novaclaw38/esp32-fermentation--app/DESIGN.md

---
name: Fermentation Monitor Dashboard
description: A dark instrument panel that reads gravity and temperature at a glance, the way a real gauge cluster does.
colors:
  panel-page: "#14110e"
  panel-surface: "#1c1712"
  panel-raised: "#262019"
  panel-border: "#332a20"
  panel-edge: "#453829"
  panel-text-secondary: "#9c8a6e"
  panel-text-primary: "#d9cbb0"
  brew-glow: "#dd9834"
  brew-accent: "#c97f22"
  brew-accent-hover: "#a8631c"
  approach: "#fb923c"
  approach-deep: "#f2751a"
  breach: "#f87171"
  breach-deep: "#ef4444"
  breach-solid: "#b91c1c"
  gauge-track: "#7a654c"
  gravity: "#4ade80"
typography:
  headline:
    fontFamily: "ui-sans-serif, system-ui, sans-serif"
    fontSize: "1.5rem"
    fontWeight: 600
    lineHeight: "1.3"
    letterSpacing: "0.025em"
  title:
    fontFamily: "ui-sans-serif, system-ui, sans-serif"
    fontSize: "0.875rem"
    fontWeight: 600
    lineHeight: "1.4"
    letterSpacing: "0.05em"
  body:
    fontFamily: "ui-sans-serif, system-ui, sans-serif"
    fontSize: "0.875rem"
    fontWeight: 400
    lineHeight: "1.5"
    letterSpacing: "normal"
  label:
    fontFamily: "ui-sans-serif, system-ui, sans-serif"
    fontSize: "0.625rem"
    fontWeight: 500
    lineHeight: "1.2"
    letterSpacing: "0.1em"
  numeral:
    fontFamily: "ui-monospace, SFMono-Regular, Menlo, Consolas, Liberation Mono, monospace"
    fontSize: "1.125rem"
    fontWeight: 600
    lineHeight: "1.1"
    letterSpacing: "normal"
rounded:
  sm: "6px"
  md: "8px"
  full: "9999px"
spacing:
  xs: "8px"
  sm: "12px"
  md: "16px"
  lg: "24px"
components:
  button-primary:
    backgroundColor: "{colors.brew-accent}"
    textColor: "#ffffff"
    rounded: "{rounded.sm}"
    padding: "6px 12px"
    typography: "{typography.body}"
  button-primary-hover:
    backgroundColor: "{colors.brew-accent-hover}"
  button-secondary:
    backgroundColor: "transparent"
    textColor: "{colors.panel-text-primary}"
    rounded: "{rounded.sm}"
    padding: "6px 12px"
    typography: "{typography.body}"
  button-secondary-hover:
    backgroundColor: "{colors.panel-raised}"
  card:
    backgroundColor: "{colors.panel-surface}"
    textColor: "{colors.panel-text-primary}"
    rounded: "{rounded.md}"
    padding: "16px"
  input:
    backgroundColor: "{colors.panel-page}"
    textColor: "{colors.panel-text-primary}"
    rounded: "{rounded.sm}"
    padding: "4px 8px"
  chip:
    backgroundColor: "{colors.panel-raised}"
    textColor: "{colors.brew-glow}"
    rounded: "{rounded.sm}"
    padding: "2px 6px"
    typography: "{typography.label}"
---

# Design System: Fermentation Monitor Dashboard

## Overview

**Creative North Star: "The Instrument Panel"**

The dashboard reads like a real gauge cluster mounted over the fermenter, not a status page pretending to be one. Every device is a radial instrument with a needle, a tick-marked dial, and a tabular numeral at its center — never a card holding a bare number and a colored badge. The ground is a warm charcoal (never pure black) so the panel has a material temperature, and the one recurring accent — amber phosphor glow — lights up nominal readings the way an analog gauge's face would, then shifts to orange and red as a reading approaches or breaches its threshold. This is a code-led build: there was no comp to defer to, so this system is read directly off the shipped dashboard and its two captured viewports, not off intent.

The system stays deliberately quiet everywhere it isn't the gauge. Cards, buttons, and forms are flat 1px-bordered panels with no shadow vocabulary of their own; the only glow in the interface is the state signal on a needle, a dial center, or an unacknowledged alert dot. Nothing decorative competes with that signal.

**Key Characteristics:**
- Warm dark charcoal panel ground, never cold or pure black
- One state vocabulary — nominal / approaching / breached / offline — expressed as glow color *and* glow intensity, reused identically everywhere a reading appears
- Tabular monospace numerals on every live digit; uppercase tracked labels beneath them on the gauge only — everything else is sentence case
- Flat, unshadowed containers; glow is a state signal, not ambient depth
- Focus-dim: bringing one instrument forward dims its neighbors instead of a badge or modal calling it out

## Colors

A single warm charcoal scale carries the whole interface; amber is the one recurring accent, doubling as both the brand color and the "nominal" gauge glow.

### Primary
- **Brew Amber** (`#dd9834` glow / `#c97f22` solid accent): the nominal-state glow on gauge needles and dial centers, and the solid accent for primary actions (Claim device, Create device) and focus rings. The same hue lit (glow) vs. flat (button fill) rather than two different ambers.

### Secondary — gauge state hues
- **Approach Orange** (`#fb923c` / deep `#f2751a`): a reading nearing its threshold — the "approaching" state, with no equivalent in the alert backend; it exists only so the panel can warn before a value actually leaves range.
- **Breach Red** (`#f87171` / deep `#ef4444`): an open alert or an out-of-range reading. Reserved exclusively for this state — never used decoratively.

### Neutral — the panel scale
- **Panel Ground** (`#14110e`): page background.
- **Panel Surface** (`#1c1712`): tile, card, and form background.
- **Panel Raised** (`#262019`): hover surface and badge/chip background.
- **Panel Border** (`#332a20`): default 1px border, divider. No longer used for the gauge track — see the Gauge component note below.
- **Panel Edge** (`#453829`): lighter edge — border/edge role only, no longer used on the gauge dial either (see below). An audit pass found it in use as real body text (alert timestamps, gauge freshness labels, form hints) at ~1.6:1 contrast, far below WCAG's 3:1 floor for any text size. Corrected to Panel Text Secondary wherever it was carrying text.
- **Panel Text Secondary** (`#9c8a6e`): secondary text, the offline-state glow color, and the gauge's tick marks — tinted warm, never plain gray. Lightened from the original `#8a7a63` (4.65:1 on the page background, but only 4.27:1 on the `panel-900` card surface most of this text actually sits against, failing AA there) to hold ≥5.3:1 against every surface it's used on.
- **Gauge Track** (`#7a654c`, gauge-specific, not a shared panel step): the dial's static ring. Started life at Panel Border's `#332a20` (1.26:1 against `panel-900` — effectively invisible, leaving the needle floating with no scale to read it against), which read as illegible rather than merely subtle. Sits between Panel Edge and Panel Text Secondary on the ramp, clearing WCAG's 3:1 non-text floor (3.21:1 / 3.40:1) while staying visibly dimmer than the tick marks it frames.
- **Panel Text Primary** (`#d9cbb0`): primary text on dark.

### Named Rules
**The Glow-Carries-State Rule.** A gauge's state is never color alone. Nominal, approaching, breached, and offline each pair a hue with a distinct glow radius (3px / 5px / 9px / none) so severity reads as intensity before hue even registers — the alert-brightness raise. Don't reintroduce state as a separate badge or icon once a gauge already carries it.

**The One Amber Rule.** `brew` is the only accent hue in the system outside the state vocabulary. It is not spent on decoration — only on the nominal glow and on primary actions.

## Typography

**Body/UI Font:** system sans stack (`ui-sans-serif, system-ui`) — unchanged from category default, deliberately not a webfont; nothing extra to load for a device meant to work on a weak connection.
**Numeral Font:** `ui-monospace, SFMono-Regular, Menlo, Consolas, Liberation Mono, monospace` — every live readout only.

**Character:** Plain system sans for everything that's prose or label; monospace tabular numerals reserved strictly for live instrument readings, so the two faces stay legible as two different kinds of information (words vs. measurements) rather than a stylistic pairing.

### Hierarchy
- **Headline** (600, 1.5rem/24px, sentence case): page titles ("Your devices", a device name).
- **Title** (600, 1rem/16px, sentence case, `panel-200`): section headers (Alerts, Fermentation, chart titles).
- **Body** (400, 0.875rem/14px): device metadata, form copy, alert reasons.
- **Label** (500, 0.625rem/10px, uppercase, tracked 0.1em): gauge instrument labels (TEMP, GRAVITY, BATTERY) only. The one place all-caps survives — it's the gauge's printed face.
- **Numeral** (600, monospace, 1.125rem sm / 1.875rem lg, `font-variant-numeric: tabular-nums`): the live digit at a gauge's center. Fixed digit width so an update never reflows its label.

### Named Rules
**The Tabular Numerals Rule.** Every live-updating digit — gauge readouts, alert temperatures — uses the monospace stack with tabular-nums. This is a legibility mechanism (digits don't jitter in width as a value ticks over), not a "technical" costume, so it is never applied to static or non-numeric text.

## Layout

A single centered column (`max-w-3xl`, `mx-auto`, `px-4 py-8`) at every breakpoint — this is a monitoring tool for a handful of devices, not a dense dashboard grid. The device list breaks into instrument tiles: one column on mobile, two columns at `sm` and above. Spacing rhythm runs `gap-3`/`gap-4` between tight sibling elements (tile contents, form fields) and `mb-6`/`mb-8` between major sections; card interiors pad at `p-4` (list tiles, settings) or `p-6` (the detail hero panel).

Device settings live on their own route (`/devices/:id/settings`) rather than inline on the detail page, split across four tabs — Profile, Setup, Tools, Data — grouped by what a visit is actually for (identity, configuration, one-off actions, destructive/data controls) rather than by underlying table. Each tab still stacks its cards in the same single column, `space-y-6` apart; nothing about the tab split changes card styling, only which cards are mounted at once.

**Focus-dim.** On the device grid, hovering or focusing one tile dims every other tile to 70% opacity (50% dropped the neighbours' secondary text below AA) over a 300ms transition — the raise borrowed from the streaming-catalog challenger. No badge or modal calls the focused tile out; the neighbors simply recede.

An internal-only admin surface (`/admin/firmware`, gated by an `is_admin()` check rather than anything device-owner-scoped) reuses the same single-column shell, card, form, and button vocabulary as the customer-facing pages — no separate "admin theme." A quiet "Firmware" text link appears in the devices page header only for an admin session; everyone else never sees it.

## Elevation & Depth

The system is flat by default — cards and panels carry a 1px border (`panel-700`) and no box-shadow. Depth and "liveness" are conveyed by glow, not shadow: a gauge's needle and dial center carry an SVG `drop-shadow` sized to the current state (0px offline, 3px nominal, 5px approaching, 9px breached), and an unacknowledged alert gets a small red halo (`0 0 6px 2px`) on its status dot. This is the instrument-panel material reading as lit from within rather than lifted off the page — a deliberate divergence from a generic shadow-elevation system, grounded in the OWN-WORLD's "amber-phosphor glow" mandate rather than a default.

### Named Rules
**The Flat-Except-Lit Rule.** Containers never cast a shadow. The only glow permitted anywhere is the state glow already defined per gauge/indicator — don't add ambient shadow or glow to a card, button, or chip that isn't reporting a live state.

## Shapes

Two radius steps: `6px` (buttons, inputs, chips — the interactive/small scale) and `8px` (cards, tiles, panels — the container scale). Full-round (`9999px`) only on the alert status dot. Borders are 1px and uniform — no accent-colored side borders on any list item or card. The gauge itself is the one non-rectangular silhouette in the system: a 240° dial (120° gap at the bottom, the classic speedometer face) rendered as a single SVG arc per instrument.

## Components

### Buttons
- **Shape:** 6px radius.
- **Primary:** `brew-600` (#a8631c) fill / white text, `hover:bg-brew-500`. Used for the one primary action per view (Claim device, Create device).
- **Secondary/Ghost:** transparent fill, 1px `panel-600` border, `panel-200` text, `hover:bg-panel-800`. Used for Cancel/Add-manually/Sign-out and settings actions.
- Both variants share `min-h-11 px-3 py-2 text-sm font-medium`; no size variant beyond this. Every button, including the confirm-first ones on the settings and admin pages ("Start new batch…", "Unclaim device…", "Remove device…", "Publish"), is at least 44px tall. An earlier note here accepted 38px (`py-2` alone) as a deliberate stop short; the 2026-09-30 polish pass measured those four at 38px and brought them to the same floor as the rest.

### Chips
- **Style:** `panel-800` background, `brew-400` sentence-case text, 12px, `rounded` (not pill). Used exclusively for the device-type badge ("TEMP + GRAVITY") next to a device name/ID — not used as a general-purpose tag.

### Cards / Containers
- **Corner Style:** 8px radius.
- **Background:** `panel-900` surface on `panel-950` page.
- **Shadow Strategy:** none — see Elevation & Depth; flat by default.
- **Border:** 1px `panel-700`, shifting to `brew-600` on hover for the interactive device tile only.
- **Internal Padding:** 16px (list tiles, settings sections) or 24px (detail-page hero panel).

### Inputs / Fields
- **Style:** `panel-950` fill, 1px `panel-600` border, 6px radius, `panel-200` text.
- **Focus:** global 2px `brew-400` outline with 2px offset (themed `:focus-visible`, not a browser default).
- **Error:** inline `breach-400` text beneath the field; no red border treatment observed.

### Navigation
- Minimal: a "← All devices" / "← {device name}" text link (`panel-400`, hover `panel-200`) is the only back-navigation; no persistent nav bar. Section headers use Title type; no active/hover state beyond the link's own color shift.

### Tab Navigation
Used once, on the device settings page: a flat row of sentence-case buttons sharing a single `panel-700` bottom border. The active tab gets `brew-400` text and a 2px `brew-400` underline (the same "solid accent" color as a primary button, not a new hue); inactive tabs are `panel-400`, hovering to `panel-200` — no background fill or pill treatment on either state. This is the same "flat, color-carries-state" logic as the gauge system applied to wayfinding rather than a live reading.

### Gauge (signature component)
The one component every surface composes. A 240°-sweep SVG dial: a dial face (a faint off-center radial dish, `panel-800`→`panel-950`, unique-gradient-ID'd per instance via `useId` so the device grid's several simultaneous gauges don't silently share one gradient definition), a static track (Gauge Track, `#7a654c`), two redline zones marking the device's own approach thresholds, tick marks with a major/minor hierarchy (the two end ticks — min/max — run longer and heavier than the four between them; `#9c8a6e`), an eased needle (700ms cubic-bezier, instant with no easing under `prefers-reduced-motion: reduce`) that pins at its travel limit rather than flying off-scale, and a tabular numeral + uppercase label positioned in the dial's actual clear zone below the arc's lower gap (not a naive full-box overlay — the hub sits at a fixed point regardless of needle angle, and the text has to stay clear of it in every state, not just the ones a screenshot happens to catch). Color and glow are driven entirely by `GaugeState` (nominal/approaching/breached/offline — see `lib/gaugeState.ts`); an offline gauge renders its numeral as "—" at 40% opacity instead of a stale value. Two sizes only: `sm` (112px, list tiles) and `lg` (224px, detail-page hero) — the freshness sub-label ("3m ago") only renders at `lg`, since the clear zone at `sm` holds the numeral and its label legibly but not a third line; staleness still reads through the gauge's own opacity at either size. A device that's overdue but not yet offline dims to 75% opacity rather than adopting a new hue — staleness is intensity, not a new signal. The `aria-label` states severity in words ("above maximum," "approaching threshold") alongside the number, not just the raw value, so the state the glow communicates to a sighted viewer also reaches a screen reader.

**Needle and hub.** A `/impeccable critique` pass (2026-09-18, dual-agent, 20/24) named the exact reason the dial read as amateur rather than premium: the needle was a uniform-width line and the hub a flat filled dot, so nothing on the dial had rendering finish. The needle is now a tapered polygon (wider at the pivot, narrower at the tip) with a thin off-center white-at-30%-opacity highlight line suggesting a machined ridge. The hub is layered — a base disc in the state color, a dark inset ring (`#000` at 40% opacity) standing in for a bezel edge, and a small off-center white highlight dot standing in for a glossy dome — all from the existing state color, no per-state gradient defs needed. Neither adds a new hue; both are built from tokens already in the system (state color + black/white at reduced opacity).

The dial's generic shape and TEMP/GRAVITY/BATTERY labels alone could belong to any monitored-device product — an audit found this explicitly. `endLabels`, an optional `["min", "max"]` pair printed at the dial's two feet, is one counter to that: it's used only on the Gravity gauge, printing real specific-gravity notation ("0.990"–"1.120") the way a hydrometer graduates its scale, and never on Temp/Battery/Tilt. It renders on the `lg` dial only: at `sm` (112px) the labels were clipped by the box edge or collided with the track's end caps, so the small gravity dial relies on its minor graduation instead. The Gravity gauge also gets five faint minor graduation ticks between its six majors (`endLabels`-gated, so this is Gravity-only) — a real hydrometer prints a graduated scale, not six even dashes, and this is the one place the dial's actual silhouette, not just its label content, differs by instrument: Temp and Battery read identically to each other on purpose, Gravity doesn't read identically to either of them.

### Fermentation Summary
Four stat cards (`grid-cols-2 sm:grid-cols-4`), same card shell as everywhere else (`panel-900`/`panel-700`/8px). Original Gravity, Current SG, and Attenuation sit in `panel-200`; ABV alone gets `brew-400` as the headline figure of the group — the one accent among four cards, not four accents. All four values are tabular numerals.

### Fermentation Stage Bar
A read-only status version of Tab Navigation's step logic, not a new pattern: five dots (Lag/Active/Slowing/Cleanup/Complete) joined by connecting rules. The active stage gets a `brew-400` dot with the gauge system's own glow treatment (`drop-shadow`, not a box-shadow); stages already passed hold `panel-400`; stages not yet reached hold `panel-700`. A guidance line underneath states what the stage means and, only when it's genuinely worth a caution (cold ambient or a stalled lag phase), renders in `approach-400` instead of `panel-400` — the same vocabulary a gauge uses for "worth a look," not a new alert channel.

### Fermentation charts
Two additions beside the existing Temperature and Gravity charts: a dual-axis Gravity+Temperature chart (SG on the left axis in the same green already established by GravityChart, temperature on the right axis in `brew-400` dashed, matching TemperatureChart's own line color), and a fermentation-rate area chart (SG points per 24h, same green, filled at 15% opacity) below it. Deliberately two charts and two axes rather than one three-axis chart: a third independently-scaled line on the combo chart was tried and read as noise, not signal, the same legibility call GravityChart itself made when it chose not to plot raw tilt and corrected SG together.

### Instrument Mark
A 40px wordmark glyph — the same 240°-dial/needle/glow grammar as Gauge, at a fixed "nominal" angle rather than a real reading (it's a mark, not an instrument; it never claims to measure anything). The one authored moment on the sign-in threshold: on mount the needle sweeps from zero to its resting angle and the glow fades in over ~900ms, once, never looping. Skips straight to the resting frame under `prefers-reduced-motion: reduce`. This is deliberately the first thing a visitor who hasn't claimed a device yet sees — the sign-in page previously carried none of this system (default Tailwind `stone` grays on an unset background, no dark panel ground), which read as an unfinished, unbranded form bolted in front of a finished product. Rebuilt onto the same card/input/button tokens as everything else in Components below.

### Loading & empty states
A gray spinner or bare "Loading…" text breaks the instrument-panel illusion at the one moment — first paint — it matters most. The device grid's loading state is a grid of dial-shaped skeleton tiles (`GaugeTileSkeleton`: the dial's silhouette in Gauge Track `#7a654c`, gently pulsing, no spinner) previewing the exact layout about to render, not a generic placeholder. An audit caught this stroke at `panel-700` (`#332a20`, 1.26:1 against the card surface) in an earlier pass — the same near-invisible-track bug the real Gauge had already been fixed for once, reintroduced in the copy that was supposed to preview it; screenshotting the two side by side is what caught it, contrast math alone wouldn't have. `animate-pulse` is disabled under `prefers-reduced-motion: reduce` globally (see `index.css`). The zero-devices empty state composes the real `Gauge` component in its own `offline` pose — dim numeral, no glow — as the centerpiece, with copy that treats it as "your first instrument, not yet wired in" rather than an apology; this reuses the system's own signature silhouette instead of a generic icon-plus-heading card.

## Do's and Don'ts

### Do:
- **Do** use the four-state vocabulary (nominal/approaching/breached/offline) — and its paired glow intensity — for any future live-reading indicator, not just Gauge.
- **Do** keep every live-updating digit in the monospace tabular stack.
- **Do** keep containers flat (1px border, no shadow); reserve glow strictly for state signaling.
- **Do** theme browser-default surfaces (selection, scrollbar, focus ring) from the panel/amber palette rather than leaving them at browser defaults.

### Don't:
- **Don't** add a status badge or icon next to a gauge — the instrument already carries its own state.
- **Don't** introduce a second accent hue; amber is the only accent outside the state vocabulary.
- **Don't** add shadows, colored side-borders, or gradients to cards, chips, or buttons — those are not part of this system.
- **Don't** widen the gauge beyond its two sizes (sm/lg) or break its 240° dial into a full circle; the speedometer face is the signature silhouette.

## Palette additions (2026-09-23 audit)

All colors now come from one module, `dashboard/src/lib/tokens.ts`, which
`tailwind.config.ts` builds its theme from and which SVG and Recharts code
imports directly. Three values that existed only as literals were promoted
into it:

- **`gravity` `#4ade80`**: the gravity data series (GravityChart, the combined
  chart, the rate chart). The one data hue that isn't a gauge state: it has to
  read as a different quantity beside the amber temperature line, not as a
  warning. 10.2:1 on panel-900.
- **`gauge-track` (`panel-500`) `#7a654c`**: the dial track and skeleton arc,
  chosen to clear the 3:1 non-text contrast floor against both panel surfaces.
- **`breach-solid` (`breach-700`) `#b91c1c`**: fill for solid destructive
  buttons. White on `breach-500` held only 3.76:1; this holds 6.5:1.

Primary buttons now darken on hover (`brew-600` → `brew-700`) instead of
lightening to `brew-500`, where white text fell to 3.21:1.

An offline gauge no longer draws its needle: resting at the bottom of its
travel, it read as "reading at the minimum".

## Sign-in and password reset (2026-09-23 critique)

Both pages share `components/auth/AuthShell` (page frame) and
`components/auth/AuthField` (labelled field), so they can't drift apart.

- **Frame:** anchored near the top (`pt-[12vh]`/`16vh`), not vertically
  centred. Centring re-centred the card, and moved the header 40–90px, every
  time an error or notice appeared. The Instrument Mark is 48px beside a
  one-line product name. Each mode has its own `h1` ("Sign in", "Create your
  account", "Reset your password", "Check your inbox") and its own
  `document.title`.
- **Fields:** labels are sentence case (`text-sm font-medium panel-400`;
  all-caps is the gauge's alone) and are tied to their inputs
  with `htmlFor`/`id`. Nothing else ever sits inside a `<label>`. Inputs are
  44px tall with a `panel-500` border (3.21:1 against the card, clearing the
  3:1 floor for UI boundaries) that turns `breach-400` in error. Placeholders
  use `panel-400`, not the browser's gray. Hints are persistent text below the
  field, never only a placeholder. Passwords have a show/hide control.
- **Validation:** the forms use `noValidate`, so the browser's white native
  tooltip never appears on the dark panel. Errors are per-field
  (`aria-invalid`, `aria-describedby`), and focus moves to the first invalid
  field. Sign-in never enforces the password length.
- **Errors in the product's words:** `lib/authErrors.ts` maps Supabase's
  strings to plain-language copy and a recovery action: reset the password
  (keeping the email), resend confirmation, or sign in instead. The error box
  takes focus.
- **Busy state:** a solid `brew-800` fill with `panel-200` text (5.70:1) and
  `aria-busy` on the form. Opacity-50 had dropped the label to 3.49:1.
- **Sent states:** "Check your inbox" replaces the form entirely, with the
  address (wrapping), a resend action and "Use a different email". No live
  submit button is left under a "we sent it" message.
- **Mark motion:** the glow now fades up (a `filter` transition from a 0px to
  a 3px drop-shadow) as the needle arrives, instead of switching on.
- **Browser surfaces:** `color-scheme: dark` on `:root`, and autofill is
  restyled to the panel ground with a brew caret.

## Atelier audit (2026-09-24)

A full audit (`/atelier audit`, rendered at 375 and 1440px with fixture
data) found the dashboard grounded but mis-weighted and the landing page on
a different, generic system. Changes:

- **Gravity is the hero on a calibrated float.** PRODUCT.md's second
  principle is "one device replaces two", but gravity was a 112px dial the
  size of battery. The `lg` dial now reads gravity (with the freshness line);
  temperature moves to `sm` and keeps its state glow, which is where alerts
  show. Hubs and uncalibrated floats keep temperature on the `lg` dial.
  Gravity end labels now sit inside the ring above each foot: outside the
  arc they hit the end caps; below the feet they lined up with the numeral.
- **Device tiles** show a float's gravity as the tile's largest number
  (hidden while the device is offline, so a days-old value can't read as
  current). The gauge stays on temperature.
- **Open alerts are named on the tile** in `breach-400` ("Sensor not
  reading, last seen 3d ago"). An offline gauge carries no glow, so a dead
  sensor used to look identical to a switched-off device — the one failure
  the product exists to prevent.
- **One chart, not three.** A calibrated float shows a single gravity +
  temperature chart with the temperature limits drawn on it, then the rate
  chart. The separate temperature, gravity and combined charts repeated the
  same two lines. Hubs keep the temperature chart; uncalibrated floats keep
  the tilt chart. The temperature-correction note is hidden below half a
  gravity point. Rate-chart ticks are whole gravity points.
- **One time format.** `formatDateTime` in `lib/chartTime.ts` ("Sep 23,
  08:51") everywhere an absolute time appears; `formatDate` for date-only.
  Alerts previously printed `9/23/2026, 8:51:16 AM`.
- **Sentence case.** All-caps is reserved for gauge labels and claim codes.
  Page titles, section heads, stat labels, stage names, tabs, chips, auth
  field labels and the sign-in wordmark are sentence case; section heads
  moved from `panel-400` 14px caps to `panel-200` 16px so they still lead.
- **44px inputs** everywhere, not just the auth forms.
- **Landing page** (`landing/`) now uses this palette and type, so a visitor
  and a signed-in owner are in the same world. Its hero is an example
  gravity curve on a hydrometer-style scale (labelled as an illustration),
  drawn once on load with the gravity glow; copy is unchanged.

## Atelier audit, second pass (2026-09-29)

A re-audit of the dashboard after the first round found nothing broken and
four craft gaps, all fixed:

- **Chart ticks sit on clean local-time boundaries.** `timeTicks` in
  `lib/chartTime.ts` places them every 1–48 hours (6 on a 48-hour chart:
  midnight, 6 AM, noon, 6 PM), labelled "Mon 6 PM" by `formatTickTime`. The
  tooltip keeps the full date and time. Recharts' own ticks were spaced from
  the first reading and landed on times like 07:14 AM.
- **Tiles say how old an open alert is**, and when a temperature alert's
  reading has returned inside the limits: "Above maximum 40m ago; back in
  range now". The alert stays open, and the gauge stays lit, until it's
  acknowledged. `describeOpenAlert` in `lib/alerts.ts` builds the text; the
  age uses a non-breaking space so a wrapped line never splits "40m / ago".
  Status lines use `text-balance`.
- **Time in range fills the hero panel** (`components/TimeInRange.tsx`,
  maths in `lib/timeInRange.ts`): "Last 48 hours, 22.0°C to 28.0°C", the hours
  spent inside those limits, and when the ferment last left them. Each
  reading holds for up to four wake intervals, the same ceiling
  `lib/connection.ts` uses before calling a device offline. Time beyond that
  is reported as "No readings for N hours", never counted as in range. Hidden
  until history has loaded and until there's an hour of data.

## Delight: the wake (2026-09-29)

One authored moment on the gauge, drawn from the product's first principle
("Never go silent"): when a gauge that is already on screen goes from offline
to live -- a device reporting for the first time, or coming back after going
silent -- the instrument wakes. The needle sweeps in from zero on the
sign-in mark's curve (900ms, `cubic-bezier(0.16, 1, 0.3, 1)`), the glow and
hub warm up behind it, and the numeral lands as the needle arrives.

- **Only on an observed transition.** It never plays on first paint, so a page
  of gauges doesn't sweep on every visit. It's skipped under
  `prefers-reduced-motion`.
- **State changes settle instead of snapping.** Needle and hub colour and glow
  now transition (400ms), so acknowledging an alert or a reading crossing its
  limit reads as the instrument responding. The acknowledged alert's dot
  fades to grey over 500ms.
- **Waiting is named.** A claimed device that has never reported says
  "Waiting for its first reading" on its tile and "Waiting for first reading"
  under its dial, not just "Hasn't reported yet" beside a dead dial.
- Implemented in `Gauge.tsx` as a small `idle → start → sweep` state driven by
  a layout effect, so the needle is never painted at its final angle before
  the sweep begins. No new dependency.

## Polish pass (2026-09-30)

An end-to-end pass over the paths around the happy path (login modes, empty,
loading and error lists, the claim and add forms, uncalibrated, never-reported
and offline devices, all four settings tabs, the admin page), rendered at 375
and 1440px and checked with axe-core (WCAG A/AA and best practices). It found
one misleading state and a handful of finish gaps:

- **A silent device no longer looks new.** A device that has reported before but
  has nothing in the 48-hour window used to show "No gravity readings yet." and
  "Not enough history yet to chart a rate." beside dead dials. The detail page
  now says "No readings in the last 48 hours. This device last reported 3d ago.
  Check that it has power and can reach your WiFi." in place of the charts.
- **Chart value axes are evenly spaced.** `niceTicks` in `lib/axisTicks.ts`
  picks a 1/2/5 step (whole degrees for temperature, at least half a gravity
  point for gravity), and each chart uses the first and last tick as its
  domain. Recharts' own ticks had put one at each end of a padded domain and
  rounded the rest: 1.065 / 1.040 / 1.025 / 1.010, or 17 / 20 / 23 / 27.
- **Admin firmware file inputs have labels** (axe: critical).
- **The four short buttons reach 44px**, the file inputs and the device-type
  radio rows too.
- **Low-battery field** stacks its label above the input like every other
  settings field; the calibration placeholders are example values (`0`), not a
  truncated copy of the hint beneath.

Left as they are: inline links inside sentences (exempt from the target-size
minimum), and native radio and checkbox controls whose labels are the full-size
target.
