novaclaw38/esp32-fermentation--app/docs/AUDIT-2026-09-23.md

# Full audit: code and UI (2026-09-23)

Scope: `dashboard/` (React/Vite), `supabase/` (migrations, RLS, `alert-notify`),
`firmware/` (both sketches), and `landing/`. This report lists findings and
suggested changes only. Nothing was fixed in this pass.

## How the evidence was gathered

- Read every source file in `dashboard/src`, every migration, the edge function,
  the landing page, and the risky parts of both firmware sketches (config
  fetch, OTA, sleep, portal, fault paths).
- `tsc --noEmit`: passes. `vite build`: passes (main chunk 457 KB / 130 KB gz;
  lazy Recharts chunk 373 KB).
- `npm run lint`: **fails**. ESLint 9 is installed, but the repo only has
  `.eslintrc.cjs`, which ESLint 9 no longer reads.
- `impeccable detect`: `dashboard/src` is clean. `landing/` has only
  advisory palette and radius drift, because it uses a separate light visual
  world.
- Rendered the real app in headless Chromium with mocked Supabase responses
  (three devices: one tilt device with 48h of data, one hub with an open
  alert, and one offline hub) at 1280px and 375px.
- WCAG contrast was computed for every foreground/background pair flagged below.
- Not tested: real devices, Realtime, touch gestures, and the email path.

---

## Audit health score

| # | Dimension | Score | Key finding |
|---|---|---|---|
| 1 | Accessibility | 2 | Unlabeled landing inputs; stage-bar labels at 1.26:1; the danger button fails AA; no tab semantics and no live regions |
| 2 | Performance | 3 | Charts are already lazy-loaded; admin and settings ship in the main chunk; the device list pulls 500 rows to find the latest reading per device |
| 3 | Responsive design | 2 | **Verified:** `/devices` overflows a 375px phone by 96px, and "Sign out" is clipped offscreen |
| 4 | Theming | 2 | Tokens exist in Tailwind, but about 40 hex literals are duplicated in Gauge and the charts; the gravity green `#4ade80` is outside the palette |
| 5 | Implementation integrity | 2 | The "Complete" stage can never be reached; a page left open never goes stale or offline; the rate chart is mislabeled |
| **Total** | | **11/20** | **Acceptable: significant work needed** |

### Implementation integrity verdict: pass, with defects

The visual system is coherent and specific to this product. It uses one
instrument vocabulary (the four gauge states), a warm panel palette, SG
notation on the gravity dial, and honest empty and error states that never
pose as reassurance. The main defects are in behavior rather than style. Two
of them break the product's own first principle, "Never go silent": the live
page cannot notice that a device has died, and the analytics state machine
cannot reach its final state.

---

## Executive summary

- **Findings:** 4 P0, 11 P1, 14 P2, 5 P3.
- **Top issues:**
  1. **P0:** A dashboard left open never shows a device going offline.
  2. **P0:** The `alert-notify` edge function accepts unauthenticated requests when `WEBHOOK_SECRET` is unset.
  3. **P0:** An empty "Sleep interval" field saves `0` to the device, and the firmware applies it without bounds.
  4. **P0:** "Complete" can never be reached, and the analytics mix in readings from the previous batch.
  5. **P1:** The device-list header breaks on phones, and several WCAG AA contrast and labeling failures remain.
- **Recommended next steps:** fix the four P0s (all small, local changes). Then
  add the missing `CHECK` constraints and restore lint, then run a UI pass
  for mobile, accessibility and token cleanup.

---

## P0: blocking

### [P0] Connection status is frozen at page load
- **Location:** `dashboard/src/pages/DeviceDetail.tsx:187`, `dashboard/src/pages/Devices.tsx:271`, `dashboard/src/lib/connection.ts`
- **Category:** Implementation integrity
- **Impact:** `getConnectionInfo(device, new Date())` only runs on render. No
  timer or `visibilitychange` handler triggers a re-render, and the Realtime
  handler appends readings without updating `device.last_seen_at`. If a
  device dies while the page is open, it keeps showing "online, 5m ago"
  indefinitely, and the "5m ago" label never advances. This contradicts
  Product Principle 1.
- **Fix:** Add a `useNow(30_000)` hook that ticks every 30s and on tab focus,
  and use it everywhere connection status is computed. In the Realtime
  reading handler, also update `last_seen_at` (`setDevice(d => ({...d, last_seen_at: row.created_at}))`).
  On `/devices`, either subscribe to `readings` inserts or re-fetch on an
  interval and on focus.

### [P0] The edge function accepts unauthenticated requests
- **Location:** `supabase/functions/alert-notify/index.ts:108`
- **Category:** Security
- **Impact:** The check is `if (WEBHOOK_SECRET) { ...check... }`, and
  `verify_jwt = false`. If the secret is unset, which is easy to miss because
  the setup has three manual steps, anyone can POST a forged `record`. The
  function then emails the real owner of any device ID, using the real device
  name, which makes it a phishing relay. It also trusts the payload body
  instead of the database.
- **Fix:** Return 500 when the secret is missing and use a constant-time
  comparison. Re-read the alert by `record.id` with the service role and use
  that row, not the posted one.

### [P0] An empty numeric field saves 0, and the firmware applies it unchecked
- **Location:** `dashboard/src/components/ThresholdForm.tsx:25-30`; `supabase/migrations/*` (no `CHECK` constraints); `firmware/*/…ino` `fetchRemoteConfig()` (tilt sketch around line 459)
- **Category:** Implementation integrity / hardware safety
- **Impact:** `Number("")` is `0`. Clearing "Sleep interval" and saving
  writes `sleep_interval_seconds = 0`. The device reads it with no bounds
  check and calls `esp_sleep_enable_timer_wakeup(0)`, so it wakes
  continuously, keeps WiFi up and drains the cell. The dashboard then computes
  every status as `offline`, because the grace period is `0 * 1.5`. The same
  applies to min/max temperature (silently set to `0`) and to the breach limit.
- **Fix:** Apply all three layers:
  1. Form: reject empty or non-finite values.
  2. Database: add `CHECK (sleep_interval_seconds between 60 and 86400)`,
     `CHECK (consecutive_breach_limit between 1 and 100)`, and
     `CHECK (temp_min_c < temp_max_c)`.
  3. Firmware: clamp remote values before using them.

### [P0] Fermentation analytics: "Complete" is unreachable and the analytics mix batches
- **Location:** `dashboard/src/lib/fermentationAnalytics.ts:134-141`, `:167-170`; `DeviceDetail.tsx:113`
- **Category:** Correctness
- **Impact:** Readings are fetched with `created_at >= now - 48h`.
  `hasFullPlateauWindow` requires `points[0].t <= latest.t - 48h`, which
  cannot be true for that window. As a result, the stage never gets past
  "Cleanup", and the guidance never says "ready for bottling". Separately,
  the rate and stage calculations use every reading in the window, including
  readings from before `fermentation_started_at`. After a "Start new batch"
  reset, the old batch's plateau pollutes the new batch's stage.
- **Fix:** Fetch history from `min(now - 48h, fermentation_started_at)`, or
  fetch a slightly wider window (for example 72h) for the analytics.
  Filter points to `t >= fermentation_started_at` before computing the rate
  and stage. Add unit tests; the module is pure and easy to test.

---

## P1: major

| # | Issue | Location | Suggested fix |
|---|---|---|---|
| 1 | **Device-list header overflows on phones.** Verified: `scrollWidth` is 471px at 375px, "Sign out" is clipped, the unit toggle wraps onto three lines, and the "TEMP + GRAVITY" badge truncates to "TEMP + …" | `Devices.tsx:119-147` | Put the title on its own row and wrap or scroll the action row. Move Firmware and Sign out into an overflow menu or footer. Let the badge wrap. `/impeccable adapt` |
| 2 | **Stage-bar future labels are 1.26:1** (`text-panel-700` on `panel-900`). They were visually unreadable in the screenshot. Nothing tells a screen reader which stage is current. | `FermentationStageBar.tsx:81` | Use `text-panel-400` at reduced weight for future stages. Wrap the bar in `<ol>` and add `aria-current="step"`. |
| 3 | **Danger buttons fail AA.** White on `breach-500` is 3.76:1, and the hover state is 2.77:1. | `RemoveDeviceForm.tsx:71`, `BatchForm.tsx:71` | Use `panel-950` text on `breach-400`, or darken the fill to about `#b91c1c`. |
| 4 | **Landing inputs have no labels**, only placeholders, which fails WCAG 1.3.1 and 3.3.2. The success and error messages are not announced to screen readers. | `landing/index.html:24,74-75` | Add a `<label>` (visually hidden is fine) and put `aria-live="polite"` on `.signup-message`. |
| 5 | **Landing copy promises features that don't exist:** "emails you when … a stalled fermentation" (the firmware says stall detection "belongs in a backend job", and none exists), "Readings every few minutes" (the default is 15 min), and "clip it on" (describes only the Hub). PRODUCT.md forbids unverified claims. | `landing/index.html:21-47` | Rewrite the copy to match shipped capability, or build the stall alert first. `/impeccable clarify` |
| 6 | **The login page shows operator instructions to end users** ("Turn off … Confirm email in the Supabase dashboard"). It also nudges the operator toward disabling email confirmation; `config.toml` already has `enable_confirmations = false`. Unverified signups make the per-account claim rate limit easy to multiply. | `Login.tsx:65-71`, `supabase/config.toml` | Show "Check your email to confirm your account", and keep confirmations on in production. Add a password-reset flow, which is currently missing entirely. |
| 7 | **Unclaim/transfer gives the next owner the previous owner's full history** (readings and alerts stay attached to the `device_id`). That is a privacy leak when a unit is sold or given away. | `20260917090000_settings_expansion.sql` `unclaim_device()`; UI copy in `UnclaimDeviceForm.tsx:40` | Store `claimed_at` as an ownership epoch, and have RLS or the views only expose rows with `created_at >= claimed_at`. Or offer "transfer with history" and "wipe history" as separate actions. |
| 8 | **Unsigned OTA over `setInsecure()` from a public bucket.** When `OTA_ENABLED` is turned on, anyone who can intercept the device's network traffic can push firmware to it. | both sketches `checkForOTAUpdate()` | Pin the Supabase CA (`setCACert`) and add a signature or SHA-256 to the manifest that the device verifies. Block enabling OTA until both are done. |
| 9 | **Owners can write every device column**, including `device_secret`, `claim_code`, `last_seen_at`, `og_*` and `device_type`, and `select("*")` returns `device_secret` to the browser. | `init_schema.sql` "users update own devices"; `useDevice.ts:24` | Use column-level `GRANT UPDATE (name, temp_min_c, …)` for `authenticated`. Revoke `SELECT` on `device_secret` and `claim_code`, and select explicit columns. |
| 10 | **The device list ignores failed side queries.** If the readings or open-alerts fetch fails, the list shows "—" or a nominal gauge instead of an error, which is the silent failure the app's own comments warn against. | `Devices.tsx:72-86` | Check `error` on both queries and show a partial-load notice. |
| 11 | **Lint is broken** (ESLint 9 with the legacy config), and there is no CI and no tests. `react-hooks` rules that would have caught the frozen-clock bug aren't running. | `dashboard/.eslintrc.cjs`, repo root | Migrate to `eslint.config.js`. Add a GitHub Action running `tsc`, `lint`, `build` and Vitest, and start with tests for `fermentationAnalytics`, `gravity`, `connection` and `gaugeState`. |

---

## P2: minor

| Issue | Location | Suggested fix |
|---|---|---|
| **The rate chart is mislabeled.** The heading says "SG per 24h", but the values are points (`+112.0`), and the tooltip says "+112.0 SG/24h" | `FermentationRateChart.tsx:42,46`; `DeviceDetail.tsx:340` | Label it "points / 24h" |
| **The charts use a category X axis**, so a 10-hour gap draws as one continuous segment and time is distorted | all four charts | Use `XAxis type="number" scale="time" dataKey="t"` with a tick formatter |
| **The gravity dial's end labels are clipped and illegible at the small size** (`0.99` is cut off on mobile) | `Gauge.tsx:149-150` | Drop the end labels below the large size, or move them inside the arc |
| **Hard-coded °C text ignores the unit toggle** in the lag guidance, the gravity correction note and the alert email | `FermentationStageBar.tsx:33`, `GravityChart.tsx:137`, `alert-notify` | Route it through `formatTemp` |
| **Stale copy:** "Enter the coefficients under *Gravity calibration* below", but calibration now lives on the Settings page | `GravityChart.tsx:97` | Link to `/devices/:id/settings` (Setup tab) |
| **The email subject says "out of range" for battery and sensor alerts** and the body has no dashboard link; the timestamp is raw UTC ISO | `alert-notify/index.ts:69-70` | Write a subject per reason, add a dashboard URL, and format the time |
| **Snooze copy says only "temperature and battery"** alerts are held back, but `ingest_alert` also drops `sensor_fault` | `SnoozeForm.tsx:46`; `settings_expansion.sql` | Either let `sensor_fault` through while snoozed (recommended, per Principle 1) or fix the copy |
| **The claim success message never shows**, because `onClaimed` hides the form immediately | `ClaimDeviceForm.tsx:74-76`, `Devices.tsx:151` | Keep the form open briefly or show a banner at page level |
| **A failed acknowledge is silent**, and there's no busy state, so a double-tap is possible | `AlertList.tsx:22-25` | Surface the error and disable the button while in flight |
| **The skeleton dial is 56px, but the real small gauge is 112px**, so the layout shifts when data loads | `GaugeTileSkeleton.tsx:29` | Match the 112px size |
| **Latest reading per device comes from `limit(500)` across all devices**, so a quiet device can show "—" even though it has readings | `Devices.tsx:72-76` | Use a `latest_readings` view with `DISTINCT ON (device_id)` |
| **Settings tabs lack `role="tablist"`, `aria-selected` and arrow-key support**, the tab isn't in the URL (it resets on reload), and there are `h3`s with no `h2` | `DeviceSettings.tsx:80-94` | Use `?tab=`, add ARIA tab semantics, and fix the heading levels |
| **Several touch targets are under 44px**: the unit toggle, Acknowledge, and the snooze chips (`px-2 py-1 text-xs`) | `UnitToggle.tsx`, `AlertList.tsx`, `SnoozeForm.tsx` | Set `min-h-[44px]` on touch devices |
| **About 40 hex literals duplicate Tailwind tokens**, and the gravity green `#4ade80` is outside the DESIGN.md palette | `Gauge.tsx`, all charts | Export a `tokens.ts` from `tailwind.config.js` as the single source, and add `gravity` to the palette and DESIGN.md |
| **The database accepts garbage readings**: there is no range check on `temperature_c` or `tilt_deg`, and `alerts.reason` is free text | migrations | Add `CHECK` constraints (for example, temperature between -40 and 125, tilt between 0 and 90, and `reason` in a known set) |
| **The waitlist has no rate limit or email-format check** (anonymous insert) | `init_schema.sql` | Add a `CHECK` on the email format, and route inserts through an RPC with a per-IP or captcha gate |
| **The alert webhook URL is the placeholder `YOUR_PROJECT`** in a tracked migration, so applying it as-is silently sends no email | `20260910124500_alert_insert_webhook_trigger.sql` | Read the URL from Vault like the secret, and fail loudly if it's missing |

## P3: polish

- Device secrets are stored in plaintext. Store `sha256(secret)` and compare hashes in `verify_device_secret`.
- Admin and Settings routes ship in the main chunk. Wrap them in `lazy()` like the charts, which would cut about 60 KB from first paint for the login screen.
- The offline gauge still draws a needle pinned at the minimum, which reads as "reading at minimum". Hide the needle or park it in the bottom gap when offline.
- The label is `"TEMP"` in `Devices.tsx:296` and `"Temp"` in `DeviceDetail.tsx:240`; it renders uppercase either way, so standardize the source string.
- Focus-dim sets neighboring tiles to `opacity-50`, which drops their secondary text below AA while hovering. Use about `opacity-70` instead.
- There's no retention policy on `readings`. At 96 rows per device per day, plan for partitioning or rollups.

---

## Patterns and systemic issues

1. **Validation lives only in the UI.** The database has almost no `CHECK`
   constraints and the firmware trusts remote config, so any UI bug (the
   `Number("")` bug here) reaches the hardware. Put the source of truth in
   Postgres.
2. **Time is computed once per render.** Any value derived from `Date.now()`
   (connection status, "ago" labels, mute expiry, lag hours) goes stale.
   One shared clock hook fixes all of them.
3. **Colors are duplicated across three sources**: Tailwind config, inline hex
   in SVG and Recharts props, and the landing page's own CSS variables.
4. **There is no automated safety net.** Lint doesn't run, and there are no
   tests or CI. The analytics bug would have been caught by one unit test.

## What's working

- The empty, error and loading states are honest. `loadError`, `notFound` and
  "Couldn't load history" are all distinct from real emptiness, which is rare
  and valuable.
- The gauge is solid instrument work: four states distinguished by both hue
  and glow size, `aria-label` values that include direction ("above
  maximum"), reduced-motion snapping, tabular numerals, and `useId` gradient
  scoping.
- The security model is mostly sound: device RPCs with per-device secrets, a
  `security_invoker` view, RLS-scoped multi-tenancy, a rate limit designed
  around the transaction-rollback problem, an unbiased claim-code alphabet,
  and careful `REVOKE … FROM PUBLIC` hygiene.
- Recharts is lazy-loaded with fallbacks sized to each chart, so there's no
  layout shift when a chart arrives.
- The firmware reports sensor faults instead of going silent, times out the
  I2C bus, escapes SSIDs in the captive portal, and times out the portal to
  save the battery.
- The code comments explain *why*, which made this audit fast.

---

## Recommended actions, in order

1. **[P0] `/impeccable harden`**: the clock hook plus Realtime `last_seen_at`
   updates, the fail-closed webhook, numeric validation in all three layers,
   and the analytics window and batch filter.
2. **[P1] Backend hardening** (not a design command): `CHECK` constraints,
   column grants, a history boundary on transfer, and OTA signing.
3. **[P1] `/impeccable adapt`**: the device-list header on mobile, touch
   targets, and the gravity dial's end labels.
4. **[P1] `/impeccable audit` fixes for accessibility**: stage-bar contrast
   and ARIA, danger-button contrast, landing labels and live regions,
   settings tab semantics.
5. **[P1] `/impeccable clarify`**: landing claims, login copy, the email
   subject and body, snooze copy, the stale calibration pointer, and the
   rate-chart units.
6. **[P1] Tooling**: an ESLint 9 flat config, Vitest for `lib/`, and a
   GitHub Actions CI workflow.
7. **[P2] `/impeccable extract`**: a `tokens.ts` single source, with gravity
   green added to the palette and DESIGN.md.
8. **[P2] `/impeccable layout`**: time-scaled chart axes and a skeleton that
   matches the real tile size.
9. **`/impeccable polish`**: a final pass.

You can ask me to run these one at a time, all at once, or in any order.
Re-run `/impeccable audit` after the fixes to see the score change.

---

## Resolution (same day)

Every finding above was addressed. Only the database migration still has to
be *applied* to the hosted project (see "Deploy steps" below).

**How the fixes were verified:**
- **Dashboard:** `npm run typecheck`, `npm run lint` (0 warnings) and `npm test` pass. There are 20 Vitest tests; the "Complete is unreachable" test was confirmed to fail against the old 48h window. `npm run build` passes, and the main chunk dropped from 457 KB to 419 KB.
- **Migrations:** all 14 applied cleanly to Postgres 16, both fresh and as an upgrade over existing data. The upgrade was exercised against the new behavior:
  - device secrets are hashed, and devices still authenticate with plaintext
  - `select *` on `devices` and writes to `device_secret` / `last_seen_at` are denied
  - a 0 sleep interval and min ≥ max are rejected
  - a new owner sees none of the previous owner's history
  - `sensor_fault` gets through a snooze
  - an unconfigured webhook logs a warning without blocking the alert insert
  - waitlist signups are validated and rate-limited
  - a −127 °C reading is rejected
- **Edge function:** `deno check` passes.
- **Firmware:** both sketches compile with `arduino-cli` for `esp32:esp32:esp32` (core 3.3), using 80% and 85% of program space.
- **UI:** re-rendered in headless Chromium at 375px and 1280px. `/devices` no longer overflows (it was 96px too wide), and the design detector is clean.
- **CI:** `.github/workflows/ci.yml` now runs all of the above on every PR.

| Finding | Fix |
|---|---|
| P0 frozen connection status | `useNow()` ticks every 30s and on tab focus; Realtime updates `last_seen_at`; the device list refreshes every 60s and on focus |
| P0 edge function accepts unauthenticated requests | Fails closed without `WEBHOOK_SECRET`, compares the secret in constant time, and re-reads the alert by id |
| P0 empty field saves 0 | Form parses fields explicitly, the database has `CHECK` constraints, and the firmware clamps remote config |
| P0 analytics | 72h analytics history (48h charts), readings filtered to the current batch, regression tests added |
| P1 mobile header | Utility row, then the title, then wrapping actions |
| P1 stage-bar contrast | Upcoming stages at 5.3:1, `<ol>` with `aria-current="step"` |
| P1 danger buttons | `breach-700` fill (6.5:1); primary hover darkens (7.1:1) |
| P1 landing accessibility | Labels, `role="status"` / `aria-live` on messages, `<ol>` steps, focus ring |
| P1 landing claims | Copy rewritten to match what ships (15-min readings, the actual alert types, both form factors) |
| P1 login copy / reset | Inbox-oriented confirmation message; "Forgot password?" plus a `/reset-password` page; confirmations on in `config.toml` |
| P1 transfer leaks history | Ownership epoch in RLS; unclaim resets per-owner settings |
| P1 unsigned OTA | `ROOT_CA_PEM` required, SHA-256 checked before boot, same-host URL check; the console hashes each build |
| P1 column-wide access | Column grants; `DEVICE_COLUMNS` instead of `*`; secrets hashed |
| P1 silent side-query failure | Partial-load alert with a Retry button |
| P1 lint / CI / tests | ESLint 9 flat config, Vitest, GitHub Actions |
| P2 items | All fixed as recommended (rate-chart units, time axes with visible gaps, end labels on the large dial only, unit-aware copy, settings deep link, email subject/link/time, snooze and `sensor_fault`, claim banner, acknowledge busy/error states, skeleton size, `latest_readings`, ARIA tabs with `?tab=`, 44px targets, `tokens.ts`, reading/reason constraints, waitlist RPC, webhook URL in Vault) |
| P3 items | Hashed secrets, lazy routes, no needle when offline, consistent "Temp" label, 70% focus-dim, opt-in `prune_readings()` |

**Also fixed while in there:** the Hub sketch went silent on a failed probe;
it now reports `sensor_fault` the same way the Temp + Gravity sketch does.

**Deploy steps:**
1. `supabase db push` (applies `20260923120000_audit_hardening.sql`).
2. Store the `alert_notify_function_url` Vault secret, and make sure
   `WEBHOOK_SECRET` is set on the function; it now refuses every request
   without it.
3. Optionally set `DASHBOARD_URL` on the function so emails link to the device.
4. Deploy the dashboard *after* the migration. The migration makes
   `select *` on `devices` a permission error, so the old dashboard breaks
   and the new one needs it.
5. Before enabling OTA: set `ROOT_CA_PEM` in each sketch, and re-upload any
   existing release so it gets a hash.

**Still open:** email confirmation stays off on the hosted project until SMTP
is configured (documented in the README). OTA images are hash-checked, not
signed, so they trust whoever can write to the bucket.
