novaclaw38/esp32-fermentation--app/.impeccable/critique/2026-09-17T09-02-16Z__dashboard.md

---
target: dashboard
total_score: 26
max_score: 40
na_heuristics: 
p0_count: 0
p1_count: 3
target_identity: "file:/home/user/fermentation-/dashboard"
timestamp: 2026-09-17T09-02-16Z
slug: dashboard
closed: true
---
Method: dual-agent (A: design-review subagent · B: detector + browser-evidence subagent), fully isolated — neither saw the other's output.

## Design Health Score

| # | Heuristic | Score | Key Issue |
|---|---|---|---|
| 1 | Visibility of System Status | 2 | A failed fetch and a genuinely empty account render identically ("No devices yet") — the moment status visibility matters most is exactly when it's silent |
| 2 | Match System / Real World | 4 | Instrument-panel metaphor, real brewer vocabulary, tick-marked dial |
| 3 | User Control and Freedom | 3 | Cancel throughout, two-step delete, reversible unclaim; no undo on low-risk saves |
| 4 | Consistency and Standards | 3 | `approach`/`breach` gauge-state hues reused for non-gauge UI (secret reveal, delete button) — a direct violation of DESIGN.md's own Do/Don't list |
| 5 | Error Prevention | 4 | Min<max validation, 0-5V battery range, "c is required" guard, typed delete confirmation |
| 6 | Recognition Rather Than Recall | 3 | Forms pre-fill; calibration recall is inherent to the domain, not a UI failure |
| 7 | Flexibility and Efficiency | 1 | No bulk actions, no keyboard shortcuts, no cross-device view — every action is a fresh per-device round trip |
| 8 | Aesthetic and Minimalist Design | 3 | Flat, restrained, matches DESIGN.md closely; docked for Settings dumping 4 forms open by default |
| 9 | Error Recovery | 2 | `ClaimDeviceForm` is a standout (human copy + retry timing); every other form shows the raw Postgres error string |
| 10 | Help and Documentation | 1 | Calibration form points a browser-app user at a firmware repo path (`firmware/README.md`) they have no way to reach |
| **Total** | | **26/40** | **Acceptable** |

## Design Specificity Verdict

**Split — strong in content and domain logic, generic in visual form.**

**LLM assessment (Assessment A):** The copy and domain logic are unmistakably fermentation-specific and could not be reused unchanged: the calibration polynomial with a named reference temperature and residual-drift term, the explicit refusal to compute ABV/attenuation because a 48h window's first point isn't the batch's true original gravity, "cold crash," 0-1.2V USB-power battery noise handling, connection status scaled to each device's own sleep interval. This is real, hard-won domain modeling, not generic CRUD with a skin.

The visual/interaction language is a well-executed but genre-borrowed skin. Swap "TEMP"/"GRAVITY" for "PH"/"ORP" and the gauge system reads as an aquarium controller; swap for "NOZZLE"/"BED" and it's a 3D-printer monitor. The direction contract itself named "analog hydrometer" as a more domain-specific candidate among the 7 considered, and the mission-control panel won on a different axis. Legitimate creative choice — but the thing a stranger would screenshot and recognize (the dial) is the least fermentation-specific part of the build, while the thing they'd have to read carefully to appreciate is the most specific part.

**Deterministic scan (Assessment B):** `impeccable detect --json` on `dashboard/src` returned zero findings (confirmed the detector engine itself is live via a synthetic bad-file sanity check outside the project — a real defect there did trigger a finding). No AI-slop tells (gradient text, bounce easing, generic icon tiles, hard-offset shadows) were present to catch. B specifically checked whether the gauge's glow/drop-shadow effects or the needle's cubic-bezier easing triggered anything — they didn't; there is no false positive to flag from this run. **Note this cuts both ways**: the same zero-findings scan also missed a real, severe contrast failure (below), which the detector's ruleset apparently doesn't check for custom Tailwind color tokens. Zero mechanical findings is not the same as zero defects.

## Overall Impression

The instrument-panel identity is genuinely well-executed at the system level — the alert-brightness hierarchy, the flat/unshadowed discipline, the closed 3-hue palette all hold up under independent scrutiny from two isolated reviewers. But both reviewers, working separately, landed on the same signature component's text-overlay layout as broken, and one of them found a severe, measurable contrast failure the automated scan missed entirely. The single biggest opportunity: the Gauge component earned all the design attention: this critique's own findings suggest it didn't get matching implementation scrutiny at the one size (`sm`, 112px) it's used in most.

## What's Working

1. **The alert-brightness hierarchy is real engineering, not decoration.** Glow radius scales 3/5/9px by state (nominal/approaching/breached) so severity reads as intensity before hue registers — verified in source, not just claimed in DESIGN.md, and it's the one place the instrument-panel metaphor earns its keep over a flat badge.
2. **`GravityChart`'s epistemic honesty.** A deliberate refusal to show ABV/attenuation, with an inline comment explaining exactly why the 48h window can't support that number, plus a visible "measured over this window only" caption and a raw→corrected temperature-correction audit trail. This resists showing a confidently wrong number to a brewer who might act on it — specific to this product's real stakes.
3. **`ClaimDeviceForm`'s error handling.** Translates `invalid_code`/`too_many_attempts` into human, time-aware copy ("try again in about 3 minutes") while genuine faults surface separately. Worth naming precisely because it proves the team can do this well — making its absence in every other form (Heuristic 9) a choice or oversight, not a capability gap.

## Priority Issues

**[P1] Gauge text-overlay layout breaks at the `sm` size (112px) — two symptoms, one root cause.**
Both assessments independently observed defects in the same component via direct screenshot inspection, without seeing each other's work. A saw the needle/hub crossing the numeral on breach/approaching-state tiles ("Basement Lager" 23.4°C, "Garage Mead" 19.6°C). B saw the same collision but characterized it as happening near mid-range (needle vertical) instead, and separately found that an offline device's numeral — a bare "—" — gets pushed high enough by the 3-line bottom-anchored stack (numeral/label/subLabel) that it's imperceptible in the screenshot at 40% opacity. The disagreement on exact trigger condition is itself useful signal: this likely isn't state-specific at all, but a general consequence of the `subLabel` line (added in the last fix round, to fold connection-freshness into the instrument) leaving too little vertical clearance in a 112px box at every needle angle. This directly violates DESIGN.md's own Tabular Numerals Rule ("an update never reflows [or obscures] its label"), and hits hardest exactly when a reading needs its most precise read.
**Fix:** measure actual clearance between the text block's top edge and the needle/hub geometry at `sm` size across the full angle range, not just a few sampled states; either shrink the needle's inner radius, add an explicit z-index/background chip behind the numeral, or move the subLabel outside the gauge's own box at `sm` size.
**Suggested command:** `/impeccable layout dashboard/src/components/Gauge.tsx` (or `/impeccable polish`, given the resolution likely touches spacing and z-order together).

**[P1] `text-panel-600` is used as real body text at 1.57-1.66:1 contrast — a severe, measurable WCAG failure the mechanical detector missed.**
B computed this directly (WCAG relative-luminance formula, not eyeballed): `#453829` on `panel-900`/`panel-950` backgrounds is 1.57:1 and 1.66:1 respectively — far below even the 3:1 AA-large floor, let alone 4.5:1 for normal text. It's used for alert timestamps (`AlertList.tsx`), the gauge's own freshness `subLabel` ("3m ago") — added specifically to satisfy the earlier finish-review's "fold connection status into the instrument" fix — and hint text across `ThresholdForm`/`CalibrationForm`. `.impeccable/design.json`'s own `colorMeta` labels this token "Panel Edge," a border/edge role, not one of the two documented text colors — this reads as token misuse, not a deliberate choice. Separately, B found `panel-400` (the documented secondary-text color) computes to 4.52:1 on the page background but only **4.27:1** on `panel-900`, the actual card/tile surface most of that text sits against — failing AA at its real, common usage context. My own contrast check during the build only tested against the page background, not the card surface where the text actually lives; this is a real gap in that earlier check, not a new regression.
**Fix:** stop using `panel-600` for any real text; reserve it for borders/edges as its own token name says. Re-verify `panel-400` against `panel-900` specifically (not just `panel-950`) and lighten it if it needs to hold 4.5:1 on the surface it's actually used on.
**Suggested command:** `/impeccable audit dashboard` (accessibility-focused) or `/impeccable typeset`.

**[P1] Devices.tsx and DeviceDetail.tsx silently discard fetch errors — a failed load looks identical to a genuinely empty account.**
`if (!loadError && data) setDevices(...)` and `setReadings((readingsData as ...) ?? [])` both fall through to the same empty-state copy ("No devices yet," "No readings yet") whether the account truly has nothing or a request just failed. This product's entire reason to exist is telling an owner whether their batch is okay without them checking manually — an owner who opens the dashboard mid-outage sees a calm "nothing to worry about" screen, which is the "never go silent" founding principle failing at the one layer (the dashboard's own reliability) nobody designed for.
**Fix:** track load errors as distinct state; render a "couldn't load — retry" affordance that's visually distinct from genuine emptiness.
**Suggested command:** `/impeccable harden dashboard`.

**[P2] Settings defaults to fully expanded, dumping 4 forms into every device page's first view.**
`<details ... open>` means rename/delete/unclaim, thresholds, snooze/email, and (for tilt devices) the 4-coefficient calibration form all render open on load — confirmed in the settings screenshots. This fails 2 of the 8 cognitive-load checklist items (one thing at a time; progressive disclosure) for a page whose primary task needs none of it, and buries the threshold edit behind unrelated forms on every visit.
**Fix:** default `<details>` to closed.
**Suggested command:** `/impeccable distill dashboard/src/pages/DeviceDetail.tsx`.

**[P2] Gauge `aria-label` never announces severity state.**
A screen-reader user hears "TEMP: 26.4°C, 3m ago" for a device in breach — the number and the timestamp, never "above maximum." Sighted users get instant severity from hue and glow intensity; a screen-reader-dependent user must manually cross-reference the separately announced min-max range and do the comparison themselves. This is exactly the gap the four-state vocabulary was built to close, and it doesn't reach the one audience most likely to need it stated explicitly rather than shown.
**Fix:** append the state in words to the label, e.g. `"TEMP: 26.4°C, above maximum, 3m ago"`.
**Suggested command:** `/impeccable audit dashboard` (accessibility).

## Persona Red Flags

**Alex (power user, 6 concurrent devices):** Gets fast temp-only triage from the tile gauges — that part works. But gravity/battery aren't visible from the list, only from each device's detail page, so checking "is anything's gravity stalled" across 6 devices means opening each one individually. The needle-overlap defect (P1) hits Alex hardest on exactly the tile in breach state, where the precise digit matters most. Adjusting a threshold means scrolling past hero gauges, two charts, and the alert list to reach Settings, repeated per device — no bulk edit, no keyboard path (Heuristic 7's 1/4 score).

**Sam (screen-reader-dependent):** Every input across every form is a real `<label>`-wrapped control with correct association (B confirmed this by direct inspection, zero unlabeled inputs found) — thresholds editing genuinely works well for Sam. But checking a batch's status doesn't: the gauge's `aria-label` omits severity (P2 above), so Sam hears a number and must reconstruct risk mentally that a sighted user gets for free from color and glow.

**Priya (brand-new owner, first device just claimed — this product's actual pre-launch reality):** Her device hasn't reported yet. She opens the dashboard and sees a nearly-blank dial at 40% opacity with a bare "—" for the numeral, and per B's direct screenshot inspection, that dash is effectively imperceptible against the dimmed SVG and muted label color. Nothing on screen tells her "this is expected, wait for the first wake cycle" — for a pre-launch product whose whole pitch is trustworthy remote monitoring, the first thing a new owner sees is visually indistinguishable from a broken sensor.

## Minor Observations

- `approach` orange and `breach` red — defined in DESIGN.md as gauge-state-exclusive — are reused for the one-time device-secret/claim-code reveals and the delete-device button respectively. Direct, checkable violations of the system's own Do/Don't list; teaches users those hues mean "administrative caution" too, diluting the at-a-glance promise.
- Alert-list rows wrap to 3 lines on mobile (390px) with the Acknowledge button staying vertically centered against the whole wrapped block, landing mid-sentence rather than at a natural edge.
- The fixed gravity-gauge range (0.99-1.12) spans mead-to-kombucha generically; a beer batch (1.050→1.010) only sweeps ~31% of the dial, since there's no configured gravity threshold to calibrate against. Acceptable given the constraint, but the needle's position isn't threshold-meaningful the way the temp needle's is.
- `UnitToggle` shows both states at once ("°C → °F") rather than just the current one — workable via its tooltip, marginally more to parse than a plain current-state label.
- "No alerts yet — good sign." is a nice, on-brand exception to an otherwise flat empty-state voice; worth extending elsewhere once the P1 empty-vs-error issue is fixed.

## Questions to Consider

1. If "never go silent" is the founding bug fix, why is a device's silence — never-reported or offline — the *quietest*, least legible state in the entire system?
2. The direction contract ranked the mission-control panel over a literal analog hydrometer, which it named as *more* domain-specific. For an audience who's likely held a hydrometer but never touched a cockpit, what did the aircraft metaphor buy that the literal brewing instrument would have lost?
3. Every successful save reassures the user; every failed load reassures no one, because it renders identically to genuine emptiness. If the two most anxious moments this product will ever produce are visually indistinguishable, has the design solved the trust problem, or only decorated it?
