novaclaw38/esp32-fermentation--app/hardware/schematic.html

# Fermentation Monitor — Sensor Node Schematic

Hand-drawn from hardware/PCB_DESIGN.md — same nets, same GPIOs the firmware already uses, plus one new pin this revision introduces (flagged below). Not a Gerber-ready capture — see "Next steps" for turning this into a real KiCad project.

USB-C charges the cell through TP4056; DW01A+FS8205 sit on the cell's low side and define the single shared GND every other net in this schematic taps into. The battery feeds a low-quiescent LDO and a GPIO-gated sense divider (both amber) — the two places this revision diverges from a naive port of the DevKit prototype. GPIO4, GPIO34, EN and IO0 are unchanged from the firmware; the divider's enable line is the one new pin this board introduces.

## Add-on: humidity/pressure (BME280, I²C)

Taps two GPIOs the Hub doesn't otherwise use. See MULTI_SENSOR_MODULES.md for the placement rationale and full add-on BOM.

BME280 in I²C mode (CSB→3V3, SDO→GND for address 0x76) on the ESP32's default I²C pins. Doesn't touch the existing DS18B20, battery, or power circuitry from the main schematic above.

Where this design deviates from the naive port — see PCB_DESIGN.md §"decisions the naive version gets wrong"

Firmware TODO introduced by this hardware revision: GPIO25 (or any free output-capable GPIO) must be driven HIGH immediately before readBatteryVoltage() and LOW right after, with pinMode(25, OUTPUT) added in setup(). Without this change the divider reads ~0V on every cycle — this is not optional, and isn't in fermentation_monitor_v1.ino yet.

## Why Q2, not a GPIO wired straight to the PMOS gate

The obvious first draft ties the GPIO directly to Q1's gate with R6 as a pull-up. That's not safe here: a push-pull GPIO driving HIGH wins over a 100kΩ pull-up regardless of what it's fighting, so the "off" state ends up at whatever the GPIO's HIGH level is — 3.3V — not at BAT+. With a freshly-charged cell at 4.2V that's VGS ≈ −0.9V on the PMOS, which is inside the threshold region for parts like the AO3401 rather than solidly off. Q2 (a cheap NPN) turns the GPIO into a low-side switch instead: GPIO HIGH pulls the gate to ~0V through Q2 (strongly on); GPIO LOW/floating leaves R6 alone to pull the gate all the way to BAT+ (Vgs = 0, solidly off, no matter the cell voltage).

## GPIO map

Pin | Net | Status
GPIO4 | DS18B20 1-Wire data | Unchanged — matches ONE_WIRE_BUS
GPIO34 | Battery ADC (ADC1_CH6, input-only) | Unchanged — matches readBatteryVoltage()
EN | Reset, RC delay | Unchanged — standard ESP32 boot circuit
IO0 | Boot-mode select | Unchanged — standard ESP32 boot circuit
U0TXD / U0RXD | UART0, programming header | Unchanged — same pins Serial.begin() already uses
GPIO25 (proposed) | Battery-divider enable | New — needs the firmware change above
GPIO21 / GPIO22 (proposed) | I²C — BME280 humidity/pressure add-on | New — see the add-on figure above; ESP32 Arduino core's default I²C pins, unused otherwise

## Other modules in this product line

Gravity/density and CO₂ don't fit on this board — each has a placement constraint (floating in the liquid; ambient room air) that puts it on its own device instead. See MULTI_SENSOR_MODULES.md for the full rationale, and their own schematics: schematic-gravity-module.html (Temp + Gravity Module — its onboard DS18B20 is a real standalone temperature reading, not just internal compensation, so it covers both temp and gravity in one device rather than needing this Hub as well) and schematic-co2-module.html (CO₂ Safety Module) — both reuse this board's power section (TP4056 + DW01A/FS8205 + low-Iq LDO + the Q1/Q2-gated battery divider) as-is.

## Next steps

This is a hand-drawn reference, not a Gerber-ready capture. Before ordering: reproduce this in KiCad or 立创EDA (.claude/skills/pcb-designer/references/kicad-workflow.md or lceda-workflow.md), run the skill's DFM pass on the real footprint placement, and confirm the ESP32-WROOM-32E's antenna keep-out against the actual board outline — none of that geometry is meaningful in a schematic-only drawing like this one.
