novaclaw38/esp32-fermentation--app/.impeccable/critique/2026-09-18T06-40-45Z__dashboard.md

---
target: dashboard Gauge/instrument panel
total_score: 20
max_score: 24
na_heuristics: 3,5,7,10
p0_count: 0
p1_count: 2
target_identity: "file:/home/user/fermentation-/dashboard"
timestamp: 2026-09-18T06-40-45Z
slug: dashboard
---
Method: dual-agent (A: a53e3c9f98f70d19f · B: ae13ebace6ddc7e05)

## Dashboard Critique — Gauge / Instrument Panel

### Design Health Score

| # | Heuristic | Score | Key Finding |
|---|---|---|---|
| 1 | Visibility of System Status | 4 | State, freshness, staleness all folded into one glyph |
| 2 | Match System / Real World | 3 | Speedometer metaphor familiar, but unearned by the current craft level |
| 3 | User Control and Freedom | n/a | Read-only display, no navigation/undo applies |
| 4 | Consistency and Standards | 4 | One state vocabulary, reused identically sm/lg/grid/hero |
| 5 | Error Prevention | n/a | Read-only, nothing to prevent |
| 6 | Recognition Rather Than Recall | 4 | Label + numeral + color together, nothing memorized |
| 7 | Flexibility and Efficiency | n/a | No power-user shortcuts apply to a gauge glyph |
| 8 | Aesthetic and Minimalist Design | 2 | Under-minimal where it matters (needle/hub/face), while a barely-visible decorative element (redline zones) adds nothing |
| 9 | Error Recovery | 3 | stateAnnouncement gives breach direction; "offline" gives no reason why |
| 10 | Help and Documentation | n/a | Not applicable to this component |
| **Total** | | **20/24** | **Good (83%)** |

### Design Specificity Verdict

**LLM assessment:** Mixed, and this is the key finding to separate from the "amateur" complaint. The dial geometry — 240° sweep, 6 ticks, needle+hub — is generic speedometer boilerplate; it could be relabeled PH/RPM/PSI with zero changes, and DESIGN.md's own earlier audit already admits this. The one genuinely product-specific detail, endLabels (real hydrometer notation on the gravity gauge), is a content choice rendered in the same generic gray as everything else — it doesn't visually announce itself as specific; a viewer has to read the numbers to notice. This is a real gap, but Assessment A's verdict is that it is not what's driving the "amateur" complaint.

**Deterministic scan:** Clean. Zero findings from impeccable detect across the whole dashboard/src tree. No false positives to flag since nothing was flagged.

**Visual overlays:** Live injection was attempted and correctly skipped, not faked — Assessment B confirmed live DOM mutation works (title change + script injection both verified), but detect.js isn't served by a plain npx vite instance; that endpoint belongs to the skill's own live-server tooling, a different process than the one the task used. No user-visible overlay exists from this run. In its place: full-resolution screenshots at 1x/3x zoom (Assessment A) and mechanical overflow/clipping checks at desktop and mobile (Assessment B) — both real evidence, just not an in-browser overlay.

### Overall Impression

The complaint is real, and it's specific: the needle, hub, and track are flat, uniform-width vector geometry with no rendering finish — no taper, no bevel, no dial face enclosing the arc. Nothing is broken (detector clean, zero layout defects, all 4 states/2 sizes render without clipping at any viewport), and the parts that don't carry visual weight — numerals, ARIA, the state-glow system — are genuinely well executed. The gap is narrow but exact: everything that should read as a machined instrument part currently reads as a diagram of one.

### What's Working

1. State-glow system (hue + glow-radius paired, respects prefers-reduced-motion) — severity readable before color even registers, a real accessibility win for colorblind users specifically.
2. Numeral typography and placement — tabular nums prevent digit-width jitter, and the clear-zone geometry (the CY/TRACK_R fix from earlier this session) actually solved a real hub/text collision bug rather than hiding it. Confirmed zero overlap at either size, any state, by Assessment B's screenshots.
3. aria-label/stateAnnouncement construction — a visual gauge's meaning is fully ported to assistive tech, not just its raw number. Most dashboards get this wrong; this one doesn't.

### Priority Issues

**[P1] Needle and hub read as flat vector lines, not machined parts**
- Location: dashboard/src/components/Gauge.tsx:210-219 (needle), :222 (hub)
- Why it matters: DESIGN.md itself calls the needle "the moving gauge" — it's the single most load-bearing visual element on the surface, and it's currently the thinnest, flattest thing on the dial: a uniform 3px line with no taper, over a hub that's a flat 6px filled circle with only a drop-shadow for depth. This is the concrete, nameable reason the complaint lands.
- Fix: Taper the needle (wider at the hub, narrower at the tip, or a two-tone fill). Give the hub a radial gradient or a thin inset ring to fake a bezel. Keep the existing glow, add a highlight.
- Suggested command: /impeccable bolder

**[P1] No dial face or bezel — the arcs float directly on the card background**
- Location: dashboard/src/components/Gauge.tsx (track/tick paths, no filled disc anywhere behind them)
- Why it matters: Without an enclosed face, the object never resolves into an instrument — it stays a diagram of one. This is core to reading as generic/cheap rather than premium, independent of the needle/hub issue above.
- Fix: Add a subtle filled circle behind the track — a radial gradient from panel-950 to panel-900, or a faint vignette — before the track path renders.
- Suggested command: /impeccable bolder

**[P2] Redline zones are functionally invisible at sm size**
- Location: dashboard/src/components/Gauge.tsx — the approach-threshold arcs, 3px stroke at 35% opacity against a 10px track
- Why it matters: A declared design feature ("static reference showing where this device's own thresholds sit") delivers nothing at the 112px size used in the device grid — the surface most people actually scan day to day. Confirmed in Assessment A's 3x crop: you have to know to look for it.
- Fix: Either raise width/opacity enough to read at 112px, or drop it at sm deliberately rather than shipping dead visual weight.
- Suggested command: /impeccable bolder

**[P2] endLabels crowd the arc ends at sm size**
- Location: dashboard/src/components/Gauge.tsx:191-213 — fixed 15px SVG font regardless of the size prop
- Why it matters: The one detail the design system claims as product-specific (real hydrometer notation) is the one element that visually breaks under its own weight at the size it's actually used most. Undercuts the system's own stated differentiator.
- Fix: Scale endLabels font size with the size prop (e.g. 11px at sm), and/or push the label radius outward proportionally.
- Suggested command: /impeccable layout

**[P3] Tick marks have no major/minor hierarchy or graduation**
- Location: dashboard/src/components/Gauge.tsx — six identical 2px lines, evenly spaced
- Why it matters: A real gauge's authority comes partly from a readable scale. Six unlabeled dashes reads as decorative rather than instrumental, compounding the other findings.
- Fix: Differentiate tick weight/length between start/mid/end at minimum, or accept the current minimal choice deliberately and compensate with the face/needle fixes above.
- Suggested command: /impeccable bolder

### Persona Red Flags

**Alex (Power User):** The sm grid is scannable for color/state, but the redline-zone signal she'd want for a fast "how close to the edge" read is invisible at that size — she has to read the numeral instead, defeating part of the gauge's purpose for exactly the workflow (scanning many devices fast) it's meant to serve.

**Sam (Accessibility-Dependent User):** The ARIA work is genuinely ahead of most dashboards. Two real gaps: "offline" gives no reason why (dead sensor vs. asleep vs. never-provisioned all announce identically), and the tick marks / redline zones are purely decorative SVG with zero text equivalent — a screen-reader user loses the "how close to threshold" signal that a sighted user gets (barely, per the P2 above) from the redline zones. No parity fallback like "12% from max" exists in the aria-label.

**First-time user (no fermentation background):** The dial genre reads instantly (everyone recognizes a speedometer), but the gravity endLabels' hydrometer notation ("0.990"–"1.120") means nothing without domain knowledge — no tooltip or legend explains it, so the one detail meant to reassure a knowledgeable brewer is invisible to exactly the audience it's aimed at.

### Minor Observations

- InstrumentMark (the sign-in wordmark) is proportionally better-crafted than Gauge at the same grammar — a smaller needle-to-track ratio at 40px accidentally reads less flimsy than the same ratio blown up to 224px.
- GaugeTileSkeleton previews layout correctly but previews none of the craft gaps above — first paint sets an expectation the real gauge then undercuts once it loads.
- The offline state (dimmed gray, dash numeral) is one of the better restraint calls in the component — appropriately "off" rather than broken-looking.
- The Battery gauge sharing the exact same generic dial as Temp/Gravity, with zero domain cue, is the single clearest instance of "could belong to any product" in the whole surface — more so than Temp or Gravity.

### Questions to Consider

1. If the needle and hub got real dimensional treatment but the dial genre stayed a generic speedometer, would "amateur" actually resolve — or is the real discomfort about genre-borrowing (this could be an aquarium controller), and finish is just the part that's easiest to point at?
2. The system explicitly forbids a second accent hue and forbids sizes beyond sm/lg — is that constraint actually blocking the fixes above (bezel, tapered needle, tick scale), or are they fully achievable inside the existing token set, meaning this is pure execution debt rather than a systemic limit?
3. Given endLabels is the one truly product-specific detail and it's invisible to anyone who doesn't already know hydrometer notation, should "specific to fermentation" even be the goal here — or should craft investment go entirely into making the generic instrument feel expensive, since that's what's actually being complained about?
