novaclaw38/esp32-fermentation--app/outputs/temp_gravity_module.pdf

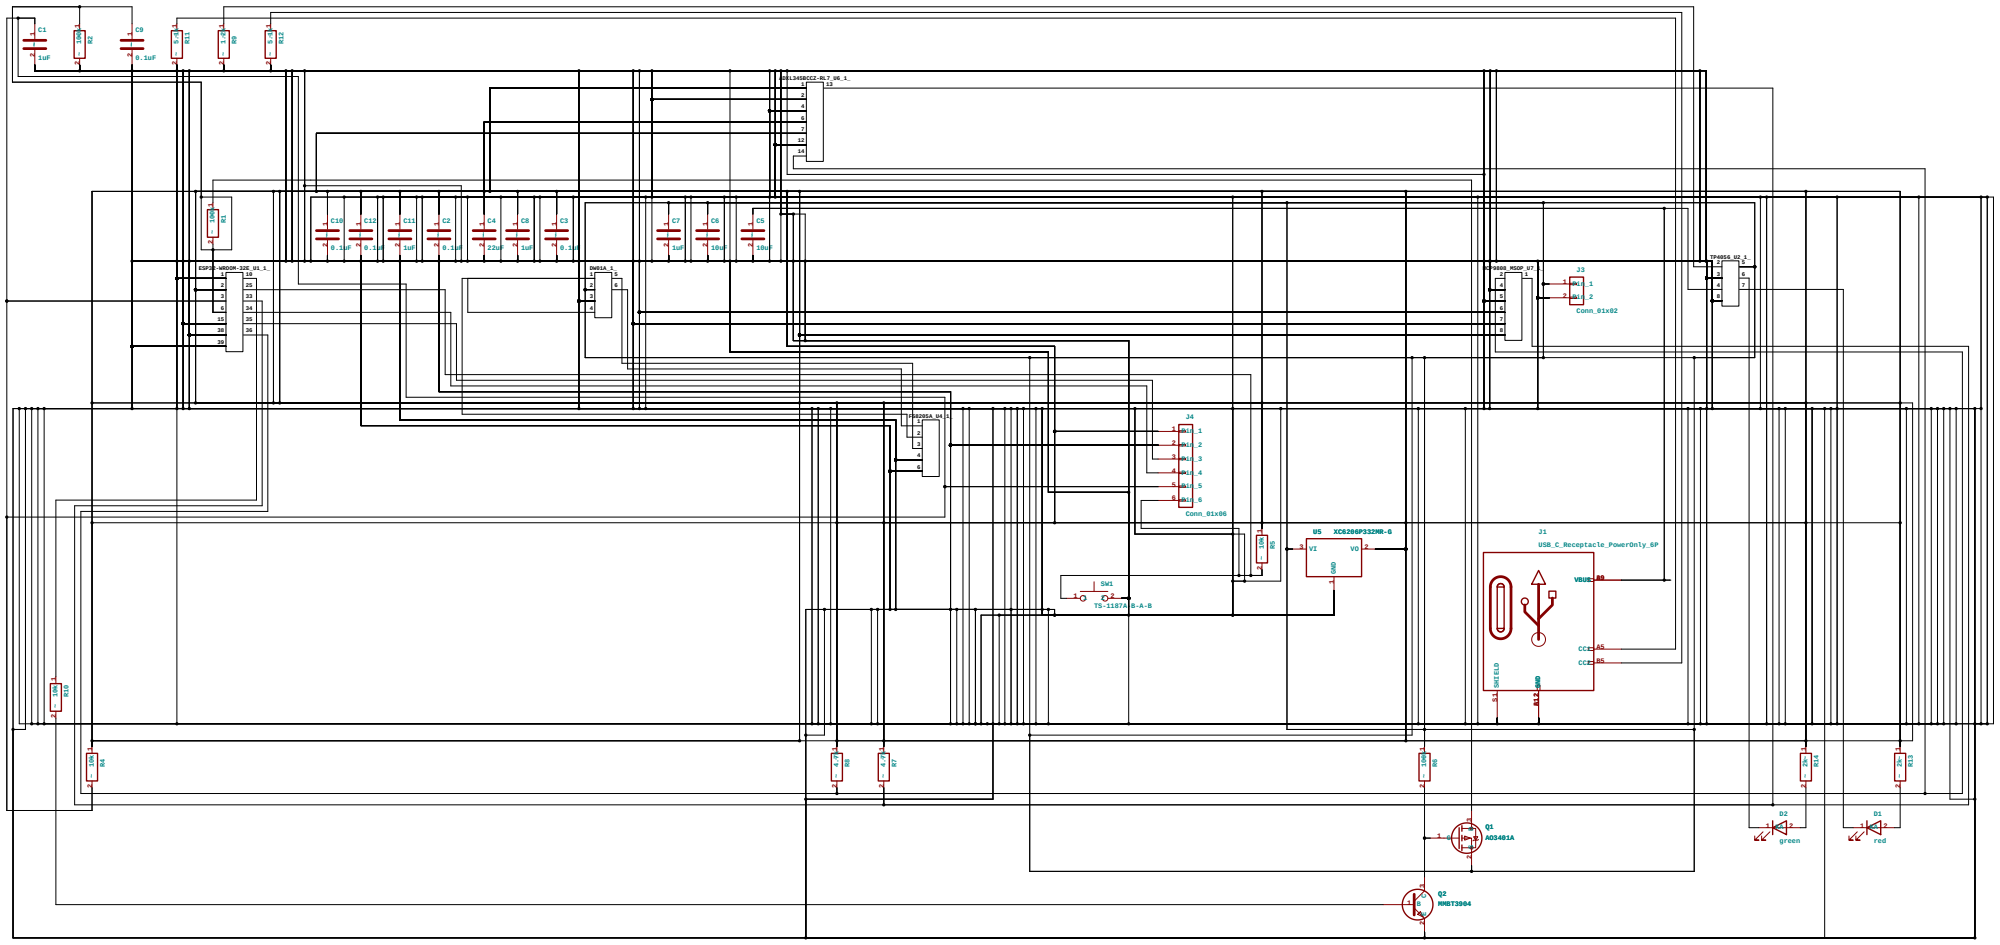
[picture p7: page 1]

ADXL345BCCZ-RL7_U6_1_ | 1 13

12
14

ESP32-WROOM-32E_U1_1_ | 1 | DW01A_1_ 1 5 | MCP9808_MSOP_U7_1_ | 2 1 | J3 1 Pin_1 2 Pin_2 Conn_01x02

5 Pin_5 6 Pin_6
