novaclaw38/esp32-fermentation--app/esp32-devkit-tilt-prototype/outputs/esp32_devkit_tilt_prototype.pdf

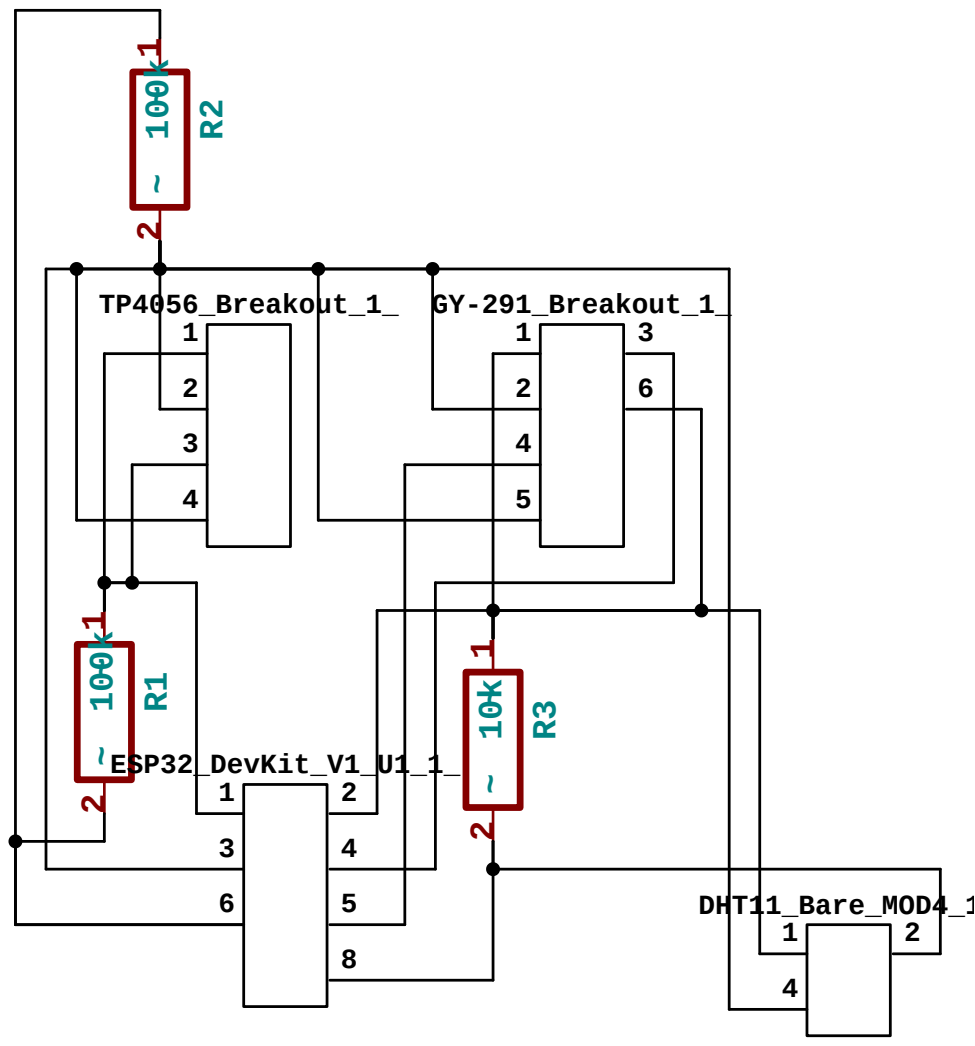
[picture p8: page 1]
TP4056_Breakout_1_ 1; GY-291_Breakout_1_ 1; DHT11_Bare_MOD4_1 1; ESP32_DevKit_V1_U1_1_ 1
