novaclaw38/esp32-fermentation--app/esp8266-tilt-prototype/outputs/esp8266_tilt_prototype.pdf

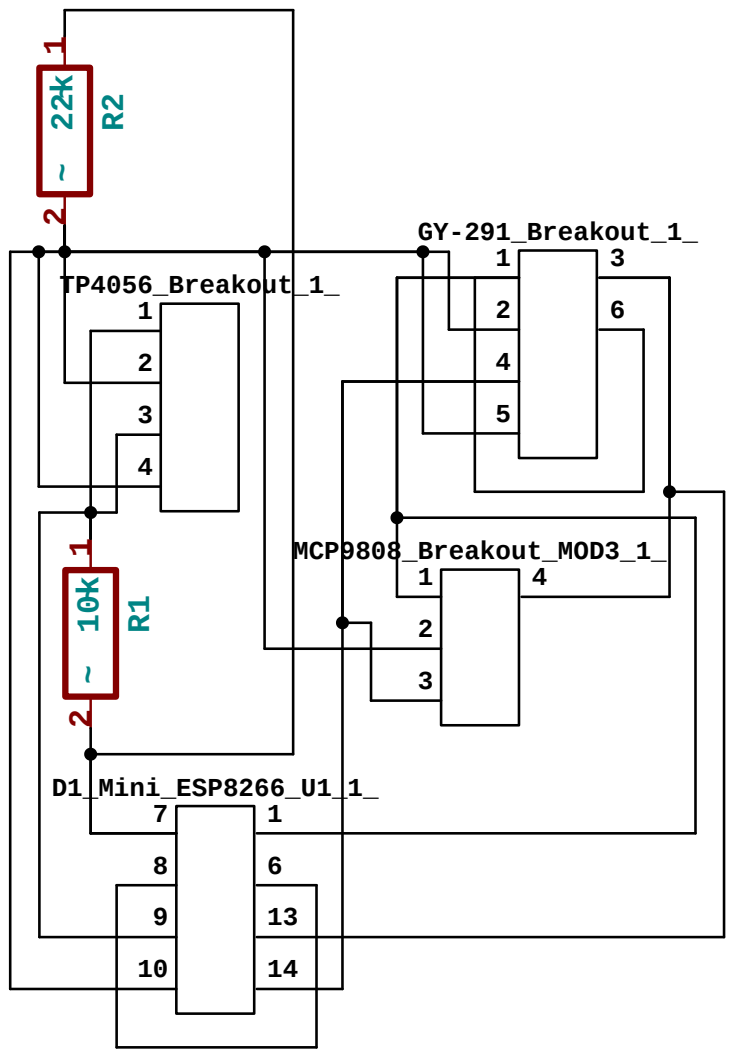
[picture p9: page 1]
TP4056_Breakout_1_ 1; GY-291_Breakout_1_ 1; MCP9808_Breakout_MOD3_1_ 1; D1_Mini_ESP8266_U1_1_ 7
