novaclaw38/esp32-fermentation--app/firmware/fermentation_tilt_v1/fermentation_tilt_v1.ino

/*
  Fermentation Monitor - Temp + Gravity Module Firmware (v1)
  -----------------------------------------------------------
  Hardware: ESP32-WROOM-32E + ADXL345 (I2C) + DS18B20 (potted, GPIO4)
  See hardware/schematic-gravity-module.html and MULTI_SENSOR_MODULES.md.

  This is a SEPARATE sketch from fermentation_monitor_v1.ino, not a variant
  of it. Same Supabase RPCs, same boot/power patterns, different sensors:

    - DS18B20 potted against the housing wall (no external probe connector)
      gives a real temperature reading, not just tilt compensation -- this
      one device covers temperature AND gravity.
    - ADXL345 gives the tilt angle the device floats at. Specific gravity
      is NOT computed here: this posts the raw angle, and the backend
      applies the per-device calibration curve (see the readings_with_gravity
      view). That way recalibrating fixes a device's whole history instead
      of baking a wrong curve into stored rows.

  Behavior each wake cycle:
    1. Wake from deep sleep
    2. Read DS18B20 + average N accelerometer samples -> tilt angle
    3. Connect to WiFi
    4. Fetch remote config (thresholds, sleep interval) via get_device_config
    5. POST {temperature, tilt, battery} via the ingest_reading() RPC
    6. Check temperature against thresholds; alert via ingest_alert() after
       CONSECUTIVE_BREACH_LIMIT consecutive breaches
    7. Occasionally check for an OTA update
    8. Deep sleep again

  Replace all CONFIG placeholders below before flashing.
*/

#include <Wire.h>
#include <WiFi.h>
#include <WiFiClientSecure.h>
#include <HTTPClient.h>
#include <Update.h>
#include "mbedtls/sha256.h"
#include <OneWire.h>
#include <DallasTemperature.h>
#include <WebServer.h>
#include <DNSServer.h>
#include <Preferences.h>

// ---------------------- CONFIG: EDIT BEFORE FLASHING ----------------------

// Compile-time WiFi is a FALLBACK, not the normal path. A customer can't edit
// and re-flash a sketch, so credentials normally arrive through the setup
// portal below and live in NVS flash. Filling these in is a bench convenience:
// they're used only when nothing is stored yet, which keeps a dev rig working
// exactly as before while a shipped unit starts its portal instead.
const char* WIFI_SSID     = "YOUR_WIFI_SSID";
const char* WIFI_PASSWORD = "YOUR_WIFI_PASSWORD";

// --- Setup portal -----------------------------------------------------------
// How long the portal stays up before giving up and sleeping. It runs the radio
// continuously, so an unbounded portal would flatten the cell on a unit that's
// sealed in a fermenter and simply out of WiFi range.
const unsigned long PORTAL_TIMEOUT_MS = 5UL * 60UL * 1000UL;

// Optional: a pin that reads HIGH while the unit is on its charger. Putting a
// sealed float on charge is the natural "I'm setting this up" moment and needs
// no button or housing penetration. -1 disables it (the bench rig has no such
// wiring). Wire it to the TP4056's charge indication if you fit one.
const int CHARGE_DETECT_PIN = -1;

// Consecutive failed connections before falling back to the portal, so a
// customer who changes router isn't stranded. Deliberately not 1 or 2: a brief
// outage shouldn't drop a mid-batch unit into AP mode.
const int WIFI_FAILURES_BEFORE_PORTAL = 12;

const char* SUPABASE_URL      = "https://YOUR_PROJECT.supabase.co";
const char* SUPABASE_ANON_KEY = "YOUR_SUPABASE_ANON_KEY";

// Unique per physical unit. Create the row with device_type = 'tilt' so the
// dashboard knows to show gravity for it.
const char* DEVICE_ID     = "ferm-tilt-001";
const char* DEVICE_SECRET = "YOUR_PER_DEVICE_SECRET";

// First-boot fallbacks only -- the values stored in Supabase win once the
// device has fetched its config at least once.
float TEMP_MIN_C = 18.0;
float TEMP_MAX_C = 24.0;
int CONSECUTIVE_BREACH_LIMIT = 3;

// Gravity moves slowly; there's no value in sampling it as often as
// temperature. 900s = 15 min. Server-configurable.
uint64_t SLEEP_INTERVAL_SECONDS = 900;

const unsigned long WIFI_TIMEOUT_MS = 15000;

// --- OTA ---
// This sketch's own manifest, separate from the Hub's -- see the note in
// fermentation_monitor_v1.ino. Publish from /admin/firmware in the
// dashboard rather than editing Storage objects by hand.
const bool OTA_ENABLED = false;
const char* OTA_MANIFEST_URL = "https://YOUR_PROJECT.supabase.co/storage/v1/object/public/firmware/tilt/manifest.json";
const int FIRMWARE_VERSION = 1;
const int OTA_CHECK_EVERY_N_CYCLES = 96; // ~once/day at a 15 min interval

// --- TLS ---
// PEM of the root CA that signs SUPABASE_URL's certificate (the OTA download
// comes from the same host). With the placeholder left in, API calls stay
// encrypted but the server is NOT verified -- fine on a bench, not for a
// shipped unit -- and OTA refuses to run at all: an unverified connection
// would let anyone on the network hand this device arbitrary firmware.
// Get it with: openssl s_client -showcerts -connect YOUR_PROJECT.supabase.co:443
// and paste the LAST certificate in the chain (the root), newlines as \n.
const char* ROOT_CA_PEM = "PASTE_ROOT_CA_PEM";

// ---------------------------- PINS / HARDWARE ------------------------------

#define ONE_WIRE_BUS   4    // DS18B20 data (4.7k pull-up to 3V3)
#define I2C_SDA        21
#define I2C_SCL        22
#define BATTERY_ADC_PIN 34  // ADC1_CH6, input-only
#define BATTERY_EN_PIN 25   // drives Q2, which switches Q1 (the divider's gate)

// ADXL345 (SDO tied to GND on this board -> address 0x53)
const uint8_t ADXL345_ADDR        = 0x53;
const uint8_t ADXL345_REG_DEVID   = 0x00;
const uint8_t ADXL345_REG_POWER   = 0x2D;
const uint8_t ADXL345_REG_FORMAT  = 0x31;
const uint8_t ADXL345_REG_DATAX0  = 0x32;
const uint8_t ADXL345_DEVID_VALUE = 0xE5;

// MCP9808 temperature sensor -- the preferred part on the production board.
// It shares the ADXL345's I2C bus, so it costs no extra GPIO and no 1-Wire
// pull-up, and at +-0.25 C it is twice as accurate as a DS18B20 for less
// money. A0/A1/A2 tied low gives 0x18.
//
// Placement decides accuracy far more than the datasheet does: a +-0.25 C part
// reading the enclosure's internal air is worse than a +-0.5 C part bonded to
// the housing wall. Whichever sensor is fitted has to be thermally coupled to
// the wall, not left sitting in still air on the board.
const uint8_t MCP9808_ADDR         = 0x18;
const uint8_t MCP9808_REG_CONFIG   = 0x01;
const uint8_t MCP9808_REG_AMBIENT  = 0x05;
const uint8_t MCP9808_REG_MANUF_ID = 0x06;
const uint16_t MCP9808_MANUF_ID    = 0x0054;
const uint8_t MCP9808_REG_RESOLUTION = 0x08;

// Full-resolution mode is 3.9 mg per LSB regardless of range (256 LSB/g).
const float ADXL345_G_PER_LSB = 0.0039;

// The liquid sloshes and the module bobs; a single sample is noisy. Averaging
// a short burst costs a few ms and takes most of that out.
const int TILT_SAMPLE_COUNT = 24;
const int TILT_SAMPLE_DELAY_MS = 10;

// ---------------------------------------------------------------------------

OneWire oneWire(ONE_WIRE_BUS);
DallasTemperature sensors(&oneWire);

// Which temperature sensor was actually found this boot. The production board
// carries an MCP9808; bench rigs are usually wired with a DS18B20 probe. Rather
// than a compile-time switch that someone will forget to flip, probe for the
// MCP9808 and fall back -- so one binary runs on both.
bool mcp9808Present = false;

RTC_DATA_ATTR int consecutiveBreaches = 0;
RTC_DATA_ATTR bool alertActive = false;
RTC_DATA_ATTR uint32_t cycleCount = 0;
RTC_DATA_ATTR int wifiFailures = 0;

// Latches a reported sensor fault so a broken sensor doesn't post an alert
// every single wake. Cleared by the first good read -- see reportSensorFault().
RTC_DATA_ATTR bool sensorFaultAlerted = false;

Preferences prefs;
String storedSsid, storedPass;

void goToSleep() {
  // Leave the battery divider disabled. R6 pulls Q1's gate to BAT+ whenever
  // Q2 isn't driven, so the divider is already off by default through sleep --
  // this just makes it explicit rather than relying on the pin's sleep state.
  digitalWrite(BATTERY_EN_PIN, LOW);

  Serial.println("Entering deep sleep for " + String((unsigned long)SLEEP_INTERVAL_SECONDS) + "s");
  Serial.flush();
  esp_sleep_enable_timer_wakeup(SLEEP_INTERVAL_SECONDS * 1000000ULL);
  esp_deep_sleep_start();
}

bool connectWiFi() {
  WiFi.mode(WIFI_STA);
  WiFi.begin(storedSsid.c_str(), storedPass.c_str());

  unsigned long start = millis();
  Serial.print("Connecting to WiFi");
  while (WiFi.status() != WL_CONNECTED) {
    if (millis() - start > WIFI_TIMEOUT_MS) {
      Serial.println("\nWiFi connect timed out");
      wifiFailures++;
      return false;
    }
    delay(250);
    Serial.print(".");
  }
  Serial.println("\nWiFi connected: " + WiFi.localIP().toString());
  wifiFailures = 0;
  return true;
}

// --- MCP9808 -------------------------------------------------------------

void mcp9808Write16(uint8_t reg, uint16_t value) {
  Wire.beginTransmission(MCP9808_ADDR);
  Wire.write(reg);
  Wire.write((uint8_t)(value >> 8));
  Wire.write((uint8_t)(value & 0xFF));
  Wire.endTransmission();
}

bool mcp9808Read16(uint8_t reg, uint16_t* out) {
  Wire.beginTransmission(MCP9808_ADDR);
  Wire.write(reg);
  if (Wire.endTransmission() != 0) return false;
  Wire.requestFrom((uint8_t)MCP9808_ADDR, (uint8_t)2);
  if (Wire.available() < 2) return false;
  uint8_t hi = Wire.read();
  uint8_t lo = Wire.read();
  *out = ((uint16_t)hi << 8) | lo;
  return true;
}

// Returns true if a real MCP9808 answered. The manufacturer ID is checked
// rather than just the ACK, so another device sitting at 0x18 can't be
// mistaken for one.
bool mcp9808Begin() {
  Wire.begin(I2C_SDA, I2C_SCL);
  // A breadboard bus with weak/missing pull-ups can wedge (a device holds SDA
  // low mid-transaction). Without this, Wire's blocking calls hang forever on
  // a wedged bus -- the whole unit would never reach goToSleep() again.
  Wire.setTimeOut(1000);

  uint16_t manuf;
  if (!mcp9808Read16(MCP9808_REG_MANUF_ID, &manuf)) return false;
  if (manuf != MCP9808_MANUF_ID) {
    Serial.println("Device at 0x18 is not an MCP9808 (manuf 0x" + String(manuf, HEX) + ")");
    return false;
  }

  // 0x03 = 0.0625 C resolution. The slowest setting at ~250 ms, which is
  // irrelevant once per wake and gives the part's full accuracy.
  Wire.beginTransmission(MCP9808_ADDR);
  Wire.write(MCP9808_REG_RESOLUTION);
  Wire.write(0x03);
  Wire.endTransmission();

  mcp9808Write16(MCP9808_REG_CONFIG, 0x0000); // continuous conversion
  return true;
}

// ~200 uA running vs ~0.1 uA shut down. Trivial while awake, but this board is
// asleep 99.5% of the time, so leaving it converting would cost more over a
// day than every reading it takes.
void mcp9808Sleep() {
  mcp9808Write16(MCP9808_REG_CONFIG, 0x0100); // SHDN
}

float mcp9808ReadC() {
  delay(260); // one full conversion at 0.0625 C resolution

  uint16_t raw;
  if (!mcp9808Read16(MCP9808_REG_AMBIENT, &raw)) {
    Serial.println("Error: MCP9808 ambient read failed");
    return NAN;
  }

  // 13-bit two's complement in bits 12:0; bits 15:13 are alert flags.
  float tempC = (raw & 0x0FFF) / 16.0;
  if (raw & 0x1000) tempC -= 256.0;
  return tempC;
}

// --- DS18B20 fallback ----------------------------------------------------

float ds18b20ReadC() {
  sensors.requestTemperatures();
  float tempC = sensors.getTempCByIndex(0);

  if (tempC == DEVICE_DISCONNECTED_C) {
    Serial.println("Error: could not read DS18B20 (check the sensor's solder joints)");
    return NAN;
  }
  return tempC;
}

// Prefers the MCP9808 when one is fitted; falls back to a DS18B20 otherwise.
// `mcp9808Present` is set during setup().
float readTemperature() {
  if (mcp9808Present) {
    float tempC = mcp9808ReadC();
    mcp9808Sleep();
    return tempC;
  }
  return ds18b20ReadC();
}

// Reads battery voltage through the gated 100k/100k divider. The divider is
// only powered while this runs -- see hardware/PCB_DESIGN.md for why it isn't
// left free-running (it would draw more than the ESP32's own deep-sleep current).
float readBatteryVoltage() {
  digitalWrite(BATTERY_EN_PIN, HIGH);
  // C7 (0.1uF) sits on the ADC node against a 50k Thevenin source, so tau is
  // ~5ms. Reading immediately would return a still-charging node, i.e. a
  // falsely low battery. 30ms is ~6 tau.
  delay(30);

  int raw = analogRead(BATTERY_ADC_PIN);

  digitalWrite(BATTERY_EN_PIN, LOW);

  // x2 undoes the 1:1 divider. The ESP32's ADC is nonlinear near its rails,
  // so treat this as a low-battery warning, not a fuel gauge -- calibrate the
  // multiplier against a multimeter on the first unit.
  return (raw / 4095.0) * 3.3 * 2.0;
}

// --------------------------- ADXL345 (inline) ------------------------------
// Small enough not to justify a library dependency; all we need is a presence
// check, a mode set, and one burst read of the six data registers.

void adxlWrite(uint8_t reg, uint8_t value) {
  Wire.beginTransmission(ADXL345_ADDR);
  Wire.write(reg);
  Wire.write(value);
  Wire.endTransmission();
}

bool adxlBegin() {
  Wire.begin(I2C_SDA, I2C_SCL);
  Wire.setTimeOut(1000); // see the note in mcp9808Begin()

  Wire.beginTransmission(ADXL345_ADDR);
  Wire.write(ADXL345_REG_DEVID);
  if (Wire.endTransmission() != 0) {
    Serial.println("ADXL345 not responding on I2C");
    return false;
  }
  Wire.requestFrom((uint8_t)ADXL345_ADDR, (uint8_t)1);
  if (!Wire.available()) {
    Serial.println("ADXL345 DEVID read returned nothing");
    return false;
  }
  uint8_t devid = Wire.read();
  if (devid != ADXL345_DEVID_VALUE) {
    Serial.println("ADXL345 DEVID mismatch: got 0x" + String(devid, HEX));
    return false;
  }

  adxlWrite(ADXL345_REG_FORMAT, 0x08); // full resolution, +/-2g
  adxlWrite(ADXL345_REG_POWER, 0x08);  // measure mode
  delay(20);                           // let the first samples settle
  return true;
}

// Back to standby (~0.1uA vs ~40uA measuring). Small next to the radio, but
// this thing is meant to sit in a fermenter for weeks.
void adxlSleep() {
  adxlWrite(ADXL345_REG_POWER, 0x00);
}

bool adxlReadRaw(int16_t* x, int16_t* y, int16_t* z) {
  Wire.beginTransmission(ADXL345_ADDR);
  Wire.write(ADXL345_REG_DATAX0);
  if (Wire.endTransmission() != 0) return false;

  Wire.requestFrom((uint8_t)ADXL345_ADDR, (uint8_t)6);
  if (Wire.available() < 6) return false;

  uint8_t b[6];
  for (int i = 0; i < 6; i++) b[i] = Wire.read();

  *x = (int16_t)((b[1] << 8) | b[0]);
  *y = (int16_t)((b[3] << 8) | b[2]);
  *z = (int16_t)((b[5] << 8) | b[4]);
  return true;
}

// Tilt angle of the module's long axis away from vertical:
//   0 deg  = floating perfectly upright
//   90 deg = lying flat
// A fermenting sample typically sits somewhere in the 25-75 deg band and
// migrates as density drops.
//
// AXIS ASSUMPTION: the board's X axis runs along the housing's long axis.
// Confirm this on the bench before trusting a calibration -- hold the module
// upright and check this prints near 0, then lay it flat and check it prints
// near 90. If it's inverted or stuck near 90, swap which of x/y/z is treated
// as the long axis below.
float readTiltDegrees() {
  double sumX = 0, sumY = 0, sumZ = 0;
  int good = 0;

  for (int i = 0; i < TILT_SAMPLE_COUNT; i++) {
    int16_t x, y, z;
    if (adxlReadRaw(&x, &y, &z)) {
      sumX += x;
      sumY += y;
      sumZ += z;
      good++;
    }
    delay(TILT_SAMPLE_DELAY_MS);
  }

  if (good == 0) {
    Serial.println("Error: no usable ADXL345 samples");
    return NAN;
  }

  double ax = (sumX / good) * ADXL345_G_PER_LSB;
  double ay = (sumY / good) * ADXL345_G_PER_LSB;
  double az = (sumZ / good) * ADXL345_G_PER_LSB;

  double magnitude = sqrt(ax * ax + ay * ay + az * az);
  // At rest the only acceleration should be gravity. Anything far off 1g means
  // the module was being handled or knocked -- that reading would produce a
  // bogus angle, so discard it rather than post a phantom gravity swing.
  if (magnitude < 0.80 || magnitude > 1.20) {
    Serial.println("Discarding tilt: |a| = " + String(magnitude, 3) +
                   "g, module likely disturbed");
    return NAN;
  }

  double tilt = atan2(sqrt(ay * ay + az * az), fabs(ax)) * 180.0 / PI;
  return (float)tilt;
}

// ------------------------------ TLS ----------------------------------------

bool rootCaConfigured() {
  return strncmp(ROOT_CA_PEM, "-----BEGIN", 10) == 0;
}

// One client for every HTTPS call this cycle. Verified against ROOT_CA_PEM
// when it's set; otherwise explicitly unverified, which is what a bare
// http.begin(url) silently did before -- now it's at least a visible choice.
WiFiClientSecure& tlsClient() {
  static WiFiClientSecure client;
  static bool configured = false;
  if (!configured) {
    if (rootCaConfigured()) {
      client.setCACert(ROOT_CA_PEM);
    } else {
      Serial.println("WARNING: ROOT_CA_PEM not set -- TLS server is not verified");
      client.setInsecure();
    }
    configured = true;
  }
  return client;
}

// ------------------------------ Supabase -----------------------------------

bool extractNumberField(const String& json, const char* key, float* out) {
  String needle = "\"" + String(key) + "\":";
  int idx = json.indexOf(needle);
  if (idx == -1) return false;
  int start = idx + needle.length();
  int end = start;
  while (end < (int)json.length() &&
         (isDigit(json[end]) || json[end] == '-' || json[end] == '.')) {
    end++;
  }
  if (end == start) return false;
  *out = json.substring(start, end).toFloat();
  return true;
}

// Same idea for a string value: "key":"value". Values here are URLs and hex
// digests, which never contain an escaped quote.
String extractStringField(const String& json, const char* key) {
  String needle = "\"" + String(key) + "\":\"";
  int idx = json.indexOf(needle);
  if (idx == -1) return "";
  int start = idx + needle.length();
  int end = json.indexOf("\"", start);
  if (end == -1) return "";
  return json.substring(start, end);
}

void addSupabaseHeaders(HTTPClient& http) {
  http.addHeader("Content-Type", "application/json");
  http.addHeader("apikey", SUPABASE_ANON_KEY);
  http.addHeader("Authorization", "Bearer " + String(SUPABASE_ANON_KEY));
}

void fetchRemoteConfig() {
  HTTPClient http;
  http.begin(tlsClient(), String(SUPABASE_URL) + "/rest/v1/rpc/get_device_config");
  addSupabaseHeaders(http);

  String payload = "{\"p_device_id\":\"" + String(DEVICE_ID) +
                    "\",\"p_device_secret\":\"" + String(DEVICE_SECRET) + "\"}";

  int httpCode = http.POST(payload);
  if (httpCode == 200) {
    String body = http.getString();
    float v;
    // Every remote value is range-checked before use. A bad row (a cleared
    // form field saved as 0, say) must not be able to put the unit into a
    // wake loop that flattens the cell, or never wake it again. Out-of-range
    // values are ignored and the previous ones kept.
    float minC, maxC;
    if (extractNumberField(body, "temp_min_c", &minC) &&
        extractNumberField(body, "temp_max_c", &maxC) &&
        minC < maxC && minC >= -40 && maxC <= 125) {
      TEMP_MIN_C = minC;
      TEMP_MAX_C = maxC;
    }
    if (extractNumberField(body, "consecutive_breach_limit", &v) && v >= 1 && v <= 100) {
      CONSECUTIVE_BREACH_LIMIT = (int)v;
    }
    if (extractNumberField(body, "sleep_interval_seconds", &v) && v >= 60 && v <= 86400) {
      SLEEP_INTERVAL_SECONDS = (uint64_t)v;
    }
    Serial.println("Remote config applied: min=" + String(TEMP_MIN_C) +
                    " max=" + String(TEMP_MAX_C) +
                    " breachLimit=" + String(CONSECUTIVE_BREACH_LIMIT) +
                    " sleepSec=" + String((unsigned long)SLEEP_INTERVAL_SECONDS));
  } else {
    Serial.println("get_device_config failed, HTTP code: " + String(httpCode) +
                    " -- keeping existing thresholds");
  }
  http.end();
}

// tiltDeg may be NAN (sensor failed, or the module was disturbed mid-read).
// The column is nullable, so post JSON null rather than skipping the whole
// reading -- the temperature is still worth recording.
bool postReading(float tempC, float tiltDeg, float batteryV) {
  HTTPClient http;
  http.begin(tlsClient(), String(SUPABASE_URL) + "/rest/v1/rpc/ingest_reading");
  addSupabaseHeaders(http);

  String tiltField = isnan(tiltDeg) ? String("null") : String(tiltDeg, 2);

  String payload = "{\"p_device_id\":\"" + String(DEVICE_ID) +
                    "\",\"p_device_secret\":\"" + String(DEVICE_SECRET) +
                    "\",\"p_temperature_c\":" + String(tempC, 2) +
                    ",\"p_battery_v\":" + String(batteryV, 2) +
                    ",\"p_tilt_deg\":" + tiltField + "}";

  int httpCode = http.POST(payload);
  bool success = (httpCode == 200 || httpCode == 201 || httpCode == 204);

  if (!success) {
    Serial.println("Reading POST failed, HTTP code: " + String(httpCode));
    Serial.println(http.getString());
  } else {
    Serial.println("Reading posted OK");
  }

  http.end();
  return success;
}

bool postAlert(float tempC, const char* reason) {
  HTTPClient http;
  http.begin(tlsClient(), String(SUPABASE_URL) + "/rest/v1/rpc/ingest_alert");
  addSupabaseHeaders(http);

  String payload = "{\"p_device_id\":\"" + String(DEVICE_ID) +
                    "\",\"p_device_secret\":\"" + String(DEVICE_SECRET) +
                    "\",\"p_temperature_c\":" +
                      // NAN would serialise as "nan", which isn't valid JSON.
                      // A sensor fault genuinely has no temperature, and the
                      // column is nullable precisely so we don't have to
                      // invent one -- a sentinel would plot as real data.
                      (isnan(tempC) ? String("null") : String(tempC, 2)) +
                    ",\"p_reason\":\"" + String(reason) + "\"}";

  int httpCode = http.POST(payload);
  bool success = (httpCode == 200 || httpCode == 201 || httpCode == 204);

  Serial.println(success ? "Alert posted OK"
                         : "Alert POST failed, HTTP code: " + String(httpCode));

  http.end();
  return success;
}

// A failed sensor read used to end the cycle right here, before WiFi. That
// made a unit with a disconnected sensor look exactly like a unit that was
// flat, out of range, or never flashed -- all silent, with no way to tell them
// apart short of a serial cable. So the device now spends the power to come up
// and say so.
//
// Latched, because the fault will still be there next wake and an alert every
// 15 minutes is noise. Re-announced once a day so a unit whose first alert was
// missed doesn't stay quiet forever.
void reportSensorFault() {
  const uint32_t REANNOUNCE_EVERY_N_CYCLES = 96; // ~24h at a 15 min interval

  bool shouldReport = !sensorFaultAlerted ||
                      (cycleCount % REANNOUNCE_EVERY_N_CYCLES == 0);
  if (!shouldReport) {
    Serial.println("Sensor still faulty (already reported)");
    return;
  }

  if (!connectWiFi()) {
    // Leave the latch alone so the next cycle with WiFi still reports it.
    Serial.println("Sensor fault, but no WiFi to report it");
    return;
  }

  if (postAlert(NAN, "sensor_fault")) {
    sensorFaultAlerted = true;
    Serial.println("Reported sensor fault to the dashboard");
  }
  WiFi.disconnect(true);
}

// Temperature alerting is identical to the Hub's -- this module measures
// temperature too, so the same thresholds and the same latch apply.
// Gravity-based alerting ("fermentation stalled") needs trend history, which
// belongs in a backend job, not here.
void checkThresholdAndAlert(float tempC) {
  bool outOfRange = (tempC < TEMP_MIN_C || tempC > TEMP_MAX_C);

  if (outOfRange) {
    consecutiveBreaches++;
    Serial.println("Out of range reading (" + String(consecutiveBreaches) +
                    "/" + String(CONSECUTIVE_BREACH_LIMIT) + ")");

    if (consecutiveBreaches >= CONSECUTIVE_BREACH_LIMIT && !alertActive) {
      const char* reason = (tempC < TEMP_MIN_C) ? "below_min" : "above_max";
      if (postAlert(tempC, reason)) {
        alertActive = true;
      }
    }
  } else {
    if (consecutiveBreaches > 0 || alertActive) {
      Serial.println("Temperature back in range, resetting alert state");
    }
    consecutiveBreaches = 0;
    alertActive = false;
  }
}

void checkForOTAUpdate() {
  if (!OTA_ENABLED) return;
  if (cycleCount % OTA_CHECK_EVERY_N_CYCLES != 0) return;

  // Fail closed: without a verified server, the manifest and the binary could
  // both come from whoever is between this device and the internet.
  if (!rootCaConfigured()) {
    Serial.println("OTA skipped: set ROOT_CA_PEM first -- refusing unverified firmware");
    return;
  }

  Serial.println("Checking for firmware update...");
  HTTPClient http;
  http.begin(tlsClient(), OTA_MANIFEST_URL);
  int code = http.GET();
  if (code != 200) {
    Serial.println("OTA manifest fetch failed, HTTP code: " + String(code));
    http.end();
    return;
  }
  String body = http.getString();
  http.end();

  float versionF;
  if (!extractNumberField(body, "version", &versionF)) {
    Serial.println("OTA manifest missing version field");
    return;
  }
  int remoteVersion = (int)versionF;
  if (remoteVersion <= FIRMWARE_VERSION) {
    Serial.println("Firmware up to date (v" + String(FIRMWARE_VERSION) + ")");
    return;
  }

  String firmwareUrl = extractStringField(body, "url");
  String expectedSha = extractStringField(body, "sha256");
  expectedSha.toLowerCase();
  if (firmwareUrl.length() == 0 || expectedSha.length() != 64) {
    Serial.println("OTA manifest missing url or sha256 -- refusing to update");
    return;
  }
  // The CA check proves who we're talking to only for hosts it covers; keep
  // the download on the same, verified project host.
  if (!firmwareUrl.startsWith(String(SUPABASE_URL) + "/")) {
    Serial.println("OTA url is not on SUPABASE_URL -- refusing to update");
    return;
  }

  Serial.println("Newer firmware v" + String(remoteVersion) + " found, downloading");
  http.begin(tlsClient(), firmwareUrl);
  code = http.GET();
  int size = http.getSize();
  if (code != 200 || size <= 0) {
    Serial.println("OTA download failed, HTTP code: " + String(code));
    http.end();
    return;
  }
  if (!Update.begin(size)) {
    Serial.println("OTA: not enough space for " + String(size) + " bytes");
    http.end();
    return;
  }

  // Hash while writing, and only commit the new image if it matches the
  // manifest. Update.end(true) is what makes the image bootable, so a
  // mismatch never gets that far.
  mbedtls_sha256_context sha;
  mbedtls_sha256_init(&sha);
  mbedtls_sha256_starts(&sha, 0);

  WiFiClient* stream = http.getStreamPtr();
  uint8_t buf[1024];
  int written = 0;
  unsigned long lastData = millis();
  while (written < size && millis() - lastData < 15000) {
    size_t avail = stream->available();
    if (avail == 0) {
      delay(5);
      continue;
    }
    int n = stream->readBytes(buf, min(avail, sizeof(buf)));
    if (n <= 0) continue;
    mbedtls_sha256_update(&sha, buf, n);
    if (Update.write(buf, n) != (size_t)n) break;
    written += n;
    lastData = millis();
  }
  http.end();

  uint8_t digest[32];
  mbedtls_sha256_finish(&sha, digest);
  mbedtls_sha256_free(&sha);
  char hex[65];
  for (int i = 0; i < 32; i++) sprintf(hex + i * 2, "%02x", digest[i]);
  hex[64] = 0;

  if (written != size || expectedSha != String(hex)) {
    Serial.println(written != size ? "OTA download incomplete -- discarded"
                                   : "OTA sha256 mismatch -- discarded");
    Update.abort();
    return;
  }
  if (!Update.end(true)) {
    Serial.println("OTA finalize failed: " + String(Update.errorString()));
    return;
  }
  Serial.println("OTA update v" + String(remoteVersion) + " verified and applied, rebooting");
  ESP.restart();
}

// ---------------------------------------------------------------------------
// WiFi credential storage + setup portal
// ---------------------------------------------------------------------------

// A shipped unit has no keyboard, no screen and (once sealed) no button, so
// credentials can't be compiled in. They live in NVS and are entered once, from
// a phone, through a captive portal the device hosts itself.

void loadCredentials() {
  prefs.begin("ferm", true);            // read-only
  storedSsid = prefs.getString("ssid", "");
  storedPass = prefs.getString("pass", "");
  prefs.end();

  // Fall back to compile-time values only if they've actually been filled in.
  if (storedSsid.length() == 0 && String(WIFI_SSID) != "YOUR_WIFI_SSID") {
    storedSsid = WIFI_SSID;
    storedPass = WIFI_PASSWORD;
    Serial.println("Using compile-time WiFi credentials (bench fallback)");
  }
}

void saveCredentials(const String& ssid, const String& pass) {
  prefs.begin("ferm", false);
  prefs.putString("ssid", ssid);
  prefs.putString("pass", pass);
  prefs.end();
}

// AP name carries the last 3 bytes of the MAC so several units in one room
// stay distinguishable, and so a support conversation can identify a unit.
String portalApName() {
  uint8_t mac[6];
  WiFi.macAddress(mac);
  char buf[32];
  snprintf(buf, sizeof(buf), "FermentationMonitor-%02X%02X%02X", mac[3], mac[4], mac[5]);
  return String(buf);
}

// SSIDs are arbitrary user-chosen text and routinely contain apostrophes and
// ampersands ("Bob's WiFi", "Tom & Jerry"). Interpolated raw, those break the
// option attribute and the network becomes unselectable -- so escape them.
String htmlEscape(const String& in) {
  String out;
  out.reserve(in.length() + 8);
  for (size_t i = 0; i < in.length(); i++) {
    char c = in[i];
    if      (c == '&')  out += "&amp;";
    else if (c == '<')  out += "&lt;";
    else if (c == '>')  out += "&gt;";
    else if (c == '"')  out += "&quot;";
    else if (c == '\'') out += "&#39;";
    else                out += c;
  }
  return out;
}

String portalPage(const String& networks, const String& note) {
  // Inlined rather than served from flash: it's one small page, and a captive
  // portal has to work before the device has any network access at all.
  String h = "<!doctype html><meta charset=utf-8>"
             "<meta name=viewport content='width=device-width,initial-scale=1'>"
             "<title>Fermentation Monitor setup</title><style>"
             "body{font:16px/1.5 system-ui,sans-serif;margin:0;padding:24px 18px;"
             "background:#f6f8fa;color:#14171c}h1{font-size:20px;margin:0 0 4px}"
             "p{color:#5c6472;margin:.4em 0}label{display:block;margin-top:14px;font-size:14px}"
             "input,select{width:100%;box-sizing:border-box;padding:10px;margin-top:4px;"
             "border:1px solid #c3cbd6;border-radius:6px;font-size:16px}"
             "button{width:100%;margin-top:18px;padding:12px;border:0;border-radius:6px;"
             "background:#9a6212;color:#fff;font-size:16px;font-weight:600}"
             ".note{background:#f4e6cc;border:1px solid #d9b372;border-radius:6px;"
             "padding:10px 12px;font-size:14px;margin-top:16px}</style>";
  h += "<h1>Fermentation Monitor</h1><p>Connect this unit to your WiFi.</p>";
  if (note.length()) h += "<div class=note>" + note + "</div>";
  h += "<form method=POST action=/save>";
  h += "<label>Network<select name=ssid>" + networks + "</select></label>";
  h += "<label>Password<input name=pass type=password autocomplete=off></label>";
  h += "<button type=submit>Save and connect</button></form>";
  // The single most common support question, answered before it's asked.
  h += "<div class=note><b>Don't see your network?</b> This device can only use "
       "<b>2.4&nbsp;GHz</b> WiFi &mdash; it has no 5&nbsp;GHz radio, so 5&nbsp;GHz "
       "networks never appear here. Many routers publish both under the same name; "
       "if yours splits them, pick the 2.4&nbsp;GHz one.</div>";
  return h;
}

void runSetupPortal() {
  WebServer server(80);
  DNSServer dns;

  // AP_STA, not AP: scanning requires the station interface, and in pure AP
  // mode WiFi.scanNetworks() returns nothing -- the list would always be empty.
  WiFi.mode(WIFI_AP_STA);
  String ap = portalApName();
  WiFi.softAP(ap.c_str());           // deliberately open: no password to convey
  IPAddress ip = WiFi.softAPIP();
  Serial.println("Setup portal started. Join WiFi \"" + ap + "\" then open http://" + ip.toString());

  // Answering every DNS query with our own IP is what makes phones pop the
  // "sign in to network" sheet instead of silently failing.
  dns.start(53, "*", ip);

  int n = WiFi.scanNetworks();
  String opts;
  for (int i = 0; i < n; i++) {
    String ssid = WiFi.SSID(i);
    if (ssid.length() == 0) continue;
    String esc = htmlEscape(ssid);
    opts += "<option value='" + esc + "'>" + esc + " (" + String(WiFi.RSSI(i)) + " dBm)</option>";
  }
  if (opts.length() == 0) opts = "<option value=''>No 2.4 GHz networks found</option>";
  Serial.println("Scan found " + String(n) + " network(s)");

  bool saved = false;
  server.on("/save", HTTP_POST, [&]() {
    String ssid = server.arg("ssid");
    String pass = server.arg("pass");
    if (ssid.length() == 0) {
      server.send(200, "text/html", portalPage(opts, "Pick a network first."));
      return;
    }
    saveCredentials(ssid, pass);
    saved = true;
    server.send(200, "text/html",
      "<!doctype html><meta charset=utf-8>"
      "<meta name=viewport content='width=device-width,initial-scale=1'>"
      "<body style=\"font:16px/1.5 system-ui,sans-serif;padding:24px\">"
      "<h1 style=font-size:20px>Saved</h1><p>Connecting to <b>" + htmlEscape(ssid) + "</b>. "
      "This page will stop working as the unit leaves its own network &mdash; that's expected. "
      "Readings should appear on your dashboard within one wake cycle.</p>");
  });

  server.on("/", HTTP_GET, [&]() { server.send(200, "text/html", portalPage(opts, "")); });
  // Captive-portal probes hit vendor-specific URLs; send them all to the form.
  server.onNotFound([&]() { server.send(200, "text/html", portalPage(opts, "")); });
  server.begin();

  unsigned long start = millis();
  while (millis() - start < PORTAL_TIMEOUT_MS) {
    dns.processNextRequest();
    server.handleClient();
    if (saved) {
      delay(1500);                    // let the browser collect the response
      Serial.println("Credentials saved, restarting");
      server.stop();
      dns.stop();
      WiFi.softAPdisconnect(true);
      ESP.restart();
    }
    delay(5);
  }

  Serial.println("Portal timed out with nothing saved; sleeping");
  server.stop();
  dns.stop();
  WiFi.softAPdisconnect(true);
  WiFi.mode(WIFI_OFF);
}

bool chargerConnected() {
  if (CHARGE_DETECT_PIN < 0) return false;
  pinMode(CHARGE_DETECT_PIN, INPUT);
  return digitalRead(CHARGE_DETECT_PIN) == HIGH;
}

void setup() {
  Serial.begin(115200);
  delay(200);

  Serial.println("\n--- Temp + Gravity module waking up ---");
  cycleCount++;

  pinMode(BATTERY_EN_PIN, OUTPUT);
  digitalWrite(BATTERY_EN_PIN, LOW);

  loadCredentials();

  // Three ways into the portal. No stored credentials covers a brand-new unit;
  // the charger covers a customer who changed router (a deliberate act, on a
  // unit with no button); the failure count covers the same case on hardware
  // without charge detection. A plain outage must NOT trigger it, which is why
  // the threshold is a dozen cycles rather than two.
  bool noCreds  = storedSsid.length() == 0;
  bool onCharge = chargerConnected();
  bool stranded = wifiFailures >= WIFI_FAILURES_BEFORE_PORTAL;

  if (noCreds || onCharge || stranded) {
    Serial.println(noCreds  ? "No WiFi credentials stored -- starting setup portal"
                 : onCharge ? "Charger detected -- starting setup portal"
                            : "WiFi unreachable for many cycles -- starting setup portal");
    wifiFailures = 0;
    runSetupPortal();
    goToSleep();                      // portal either restarted us or timed out
    return;
  }

  sensors.begin();

  // Probe for the MCP9808 before reading. Wire.begin() is called inside both
  // mcp9808Begin() and adxlBegin(); calling it twice is harmless.
  mcp9808Present = mcp9808Begin();
  Serial.println(mcp9808Present ? "Temperature sensor: MCP9808 (I2C)"
                                : "Temperature sensor: DS18B20 (1-Wire fallback)");

  float tempC = readTemperature();

  float tiltDeg = NAN;
  if (adxlBegin()) {
    tiltDeg = readTiltDegrees();
    adxlSleep();
  }

  // Temperature is this module's primary reading, so there's no reading to
  // post without it -- but staying silent would make a broken sensor look
  // like a dead device. Announce the fault instead, then sleep.
  if (isnan(tempC)) {
    Serial.println("Temperature read FAILED -- no reading to post this cycle");
    reportSensorFault();
    goToSleep();
    return;
  }

  // A good read clears the latch, so a sensor that recovers (or a reseated
  // connector) will report the next fault rather than staying latched forever.
  sensorFaultAlerted = false;

  Serial.println("Temperature: " + String(tempC, 2) + " C");
  Serial.println("Tilt: " + (isnan(tiltDeg) ? String("unavailable") : String(tiltDeg, 2) + " deg"));

  float batteryV = readBatteryVoltage();

  if (connectWiFi()) {
    fetchRemoteConfig();
    postReading(tempC, tiltDeg, batteryV);
    checkThresholdAndAlert(tempC);
    checkForOTAUpdate();
    WiFi.disconnect(true);
  } else {
    // Keep counting breaches locally so a WiFi outage doesn't reset the
    // consecutive-breach state; the alert fires once connectivity returns.
    checkThresholdAndAlert(tempC);
    Serial.println("Skipped upload (no WiFi), will retry next cycle");
  }

  goToSleep();
}

void loop() {
  // Never reached - deep sleep restarts execution from setup().
}
