novaclaw38/esp32-fermentation--app/(commit log)

2026-09-10 Build Fermentation Monitor MVP: firmware, Supabase backend, dashboard, landing page
    Implements the Phase 1 MVP from the implementation plan:
    - ESP32/DS18B20 firmware with deep sleep, threshold alerting, remote
    config fetch, and an optional OTA update path
    - Supabase schema with RLS and per-device-secret RPCs (ingest_reading,
    ingest_alert, get_device_config) so the shared anon key alone can't
    read/write another customer's device data
    - alert-notify Edge Function that emails via Resend on new alerts
    - React/TypeScript dashboard: magic-link auth, device list, live
    reading + 48h chart, alert history/ack, threshold editor
    - Static landing page with a Supabase-backed waitlist signup form f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
2026-09-10 Sync Supabase migrations with the provisioned project
    Provisioned a live Supabase project (fermentation-monitor) and applied
    the schema against it, plus follow-up hardening found while doing so:
    - verify_device_secret was still callable via PostgREST after revoking
    from anon/authenticated, because Postgres grants EXECUTE to PUBLIC by
    default on function creation -- needs an explicit revoke from public
    - wired alert emails via a pg_net trigger on alerts insert instead of
    the dashboard's manual Database Webhooks UI, so it's one migration
    instead of a click-through step
    - RLS policies now wrap auth.uid() in (select auth.uid()) per the
    Supabase performance advisor, and devices.user_id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
2026-09-10 Wire real Supabase project config into dashboard and landing page
    Fills in the live fermentation-monitor project's URL/anon key so both
    the dashboard build and the landing page's waitlist form work as-is.
    Committing dashboard/.env.production is intentional: the anon key is
    meant to be public (RLS-protected, not secret), and this lets Vercel's
    git-integration build succeed without a manual project env var step.
    Claude-Session: https://claude.ai/code/session_012XBrGNqEr6JFfXLL8C4TtV
2026-09-11 Add PCB design for the small-batch hardware, install pcb-designer skill
    Installs the third-party pcb-designer Claude Code skill (MIT, from
    github.com/SPREsxm/claude-pcb-designer) as a project skill, and uses it
    to produce hardware/PCB_DESIGN.md: a custom-PCB path for the Phase 2
    pre-sold batch that replaces the DevKit + perfboard + breakout-module
    BOM, with zero firmware changes required.
    Flags two things a naive port would get wrong: wiring the battery
    straight into the module's 3V3 pin would exceed the ESP32's 3.6V
    absolute max on a freshly-charged cell, and a generic AMS1117-class
    LDO's ~5mA quiescent current would roughly double the board's deep-sleep
    draw, undermining the "runs weeks o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
2026-09-11 Add hand-drawn schematic for the sensor node PCB
    hardware/schematic.html covers every net in PCB_DESIGN.md: USB-C charge
    path, DW01A+FS8205 battery protection, the low-Iq LDO, the gated
    battery-sense divider, and the ESP32-WROOM-32E with its DS18B20 and
    programming-header connections. Published as an artifact for easy
    viewing.
    Also fixes a real circuit bug found while drawing it: wiring the GPIO
    straight to the battery-divider PMOS's gate can't guarantee it turns off,
    since a push-pull GPIO driving HIGH (3.3V) overrides the pull-up
    resistor regardless of what it's fighting, leaving Vgs around -0.9V on a
    freshly-charged cell -- inside the threshold region for parts like the
    AO3401. Added Q2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
2026-09-11 Document the live Vercel deployment
    Both fermentation-monitor-dashboard and fermentation-monitor-landing are
    now deployed to Vercel, git-linked to this branch for auto-deploy on
    push. Had to disable Vercel's SSO deployment protection on both projects
    -- it covers even the default .vercel.app domain by default, which would
    have put the public landing page and the customer-facing dashboard
    behind a Vercel login wall. The app's actual access control is Supabase
    auth/RLS, unaffected by this.
    Flags one remaining manual step: the dashboard's live URL needs to be
    added to Supabase's Auth redirect allow-list for magic-link sign-in to
    work from the deployed site -- not something settable via the Sup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
2026-09-11 Update implementation plan BOM with the custom-PCB costs
    Adds a v2 parts-list table (custom PCB path, Phase 2 batch) alongside
    the original v1 perfboard prototype BOM, derived from the actual
    component list in hardware/PCB_DESIGN.md: bare ESP32-WROOM-32E,
    TP4056 + DW01A/FS8205 protection, low-Iq LDO, and the on-board
    divider/pull-ups, replacing the DevKit + separate TP4056 module +
    perfboard. Comes out to ~$11.50-20/unit vs. the original ~$12-25,
    mainly from LCSC-sourced SMT assembly undercutting retail modules.
    Updates Phase 2's batch budget line and the repo status section to
    match.
    Claude-Session: https://claude.ai/code/session_012X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
2026-09-12 Add humidity, gravity/density, and CO2 sensor modules
    Extends the hardware line beyond the single Hub board, with each
    sensor's physical placement constraint deciding its form factor rather
    than bolting all four onto one PCB:
    - Humidity: a BME280 add-on to the existing Hub board (I2C, GPIO21/22)
    -- documented and drawn as a second figure in schematic.html.
    - Gravity/density: a new standalone Tilt Module (schematic-gravity-
    module.html) -- a sealed floating device (ESP32-WROOM-32E + ADXL345
    accelerometer + potted DS18B20, no external probe connector since the
    whole thing is already submerged), reusing the Hub's validated power
    section (TP4056 + DW01A/FS8205 + low-Iq LDO + Q1/Q2-gat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
2026-09-12 Combine temp + gravity onto one unit instead of Hub + separate device
    The gravity/tilt module already needs its own DS18B20 to compensate the
    tilt->SG curve -- that reading has no reason to stay internal-only. It's
    posted as a real, independent temperature value, so a customer who wants
    both temperature and gravity just needs this one floating device, not a
    Hub plus a separate gravity sensor. Renamed "Tilt/Gravity Module" to
    "Temp + Gravity Module" throughout and updated the docs/schematics to
    say so explicitly, rather than leaving it as an implementation detail.
    The Hub remains the right product for temp-only or humidity.
    Claude-Sessi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
2026-09-12 Add Temp + Gravity Module firmware and tilt schema support
    New sketch firmware/fermentation_tilt_v1 for the floating module: reads
    the potted DS18B20 and an ADXL345 over I2C, averages a burst of samples
    into a tilt angle, and posts {temperature_c, tilt_deg, battery_v} through
    the existing per-device-secret RPCs. Temperature alerting is unchanged --
    this module measures temperature too, so the Hub's thresholds and latch
    apply as-is.
    Gravity is deliberately NOT computed on-device. The firmware posts raw
    tilt and the new readings_with_gravity view applies each device's
    calibration polynomial, so recalibrating a unit corrects its whole
    history instead of baking a wrong curve into stored rows. G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
    [fermentation_tilt_v1.ino]
2026-09-12 Replace magic-link auth with email + password sign-in
    Magic links depended on Supabase's built-in mail service for every single
    sign-in. That service is rate-limited to a handful of messages an hour and
    isn't meant for production, so sign-in was effectively broken. Password
    auth removes the email dependency from sign-in entirely -- and, as a side
    benefit, removes the redirect-URL allow-list configuration the magic-link
    flow needed.
    Login.tsx now does sign-in and account creation with email + password,
    with a client-side minimum length check and real Supabase errors surfaced
    to the user.
    One case worth handling explicitly: a signup that succeeds but returns no
    session means the project stil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
2026-09-12 Record that email/password auth is verified working end-to-end
    "Confirm email" is now off on the live project, so the README's "manual
    step still needed" was stale. Reframed as setup that's done here but
    still required on a fresh project, and recorded what was actually
    verified against the live backend: signup returns a session with no mail
    sent, sign-in works, wrong passwords are rejected, and a signed-in user
    can add a device and read readings back through RLS.
    Kept the warning that confirmation should go back on once real SMTP is
    configured, since unverified addresses mean someone can register an
    email they don't own.
    Claude-Session: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
2026-09-12 docs: bring implementation plan in line with the Temp + Gravity unit
    The schematic, hardware notes, firmware and schema all describe a single
    floating unit that reports temperature and gravity, but the implementation
    plan still said to "skip gravity/density sensing in v1" and treated it as
    an unbuilt v2 upsell. Its BOM tables covered only the Hub.
    - Replace the skip-gravity framing: the sequencing (sell temp first) still
    holds, but the gravity hardware and firmware now exist, so it's a second
    SKU rather than an unknown-cost future project.
    - Add a "two devices, not three" section explaining why the floating unit
    covers both readings — it needs a temperature sensor anyway to
    compen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
2026-09-12 dashboard: chart gravity for Temp + Gravity units
    The tilt/calibration schema and the readings_with_gravity view were already
    in place, but the dashboard only ever charted temperature, so a floating
    module's gravity data landed in Postgres and was never displayed.
    - Read the device page from `readings_with_gravity` instead of the
    `readings` table, picking up the server-computed `gravity_sg`.
    - Add `GravityChart`. An uncalibrated device has a null gravity on every
    row, which would render as a blank chart, so it plots the raw tilt angle
    instead and says the numbers aren't SG rather than implying they are.
    - Add `CalibrationForm` for the a/b/c/d coefficients. Without somewhere to
    enter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
2026-09-12 hardware: add the complete Temp + Gravity parts list, fixing three BOM gaps
    The module BOM in MULTI_SENSOR_MODULES.md was a board-level sketch, not
    something you could order from. Reconciling it against the schematic turned
    up three real problems.
    - USB-C CC1/CC2 pull-downs (5.1k) were missing from both this module's BOM
    and the Hub's. A USB-C sink must present them or a charger never enables
    VBUS, so the unit would not charge at all. It passes on the bench because
    a legacy USB-A-to-C cable carries its own pull-up, so the fault would only
    appear on a customer's C-to-C charger. PCB_DESIGN.md had it right in the
    DFM checklist but called the resistors "optional" in the BOM line for J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
2026-09-12 hardware: size R9 for the 350mAh cell (6.8k, not 1.2k)
    The Temp + Gravity module inherited the Hub's R9 = 1.2k, which programs the
    TP4056 for ~1A. That is correct for the Hub's 18650 and wrong here: this
    housing takes a ~350mAh 10440 or pouch cell, so 1A is roughly 2.9C, about
    three times any such cell's rated charge current -- a cell-damage and venting
    risk rather than merely poor cycle life.
    I_charge = 1200 / R_prog (amps, ohms). 350mAh at a conservative 0.5C wants
    175mA, so R_prog = 6857 ohms; the nearest E24 value, 6.8k, gives 176mA
    (0.504C). Charge takes ~2h constant-current, 2.5-3h including the CV tail,
    terminating near 18mA. The datasheet's own current table runs a few percent
    above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
2026-09-12 Correct tilt-derived gravity for temperature
    The floating module carries its own DS18B20 specifically because the
    tilt -> SG relationship shifts with temperature, but nothing used the
    temperature it reported: the view applied a tilt-only polynomial. The
    rationale and the code disagreed, and the reading was doing one job
    (customer-facing temperature) instead of two.
    Applies the standard hydrometer correction to a 20C reference. Across
    5-35C it moves a reading by about -1.9 to +4.3 gravity points -- the
    difference between calling a batch finished at 1.010 and still working
    at 1.014.
    The correction is measured from a new per-device calibration_temp_c, not
    from a hardcoded 20C. The polynomial'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
2026-09-13 Reprice against RAPT, and widen the float to 37mm on an 18650
    Two corrections that came out of actually checking the competition
    (September 2026) rather than assuming.
    PRICING. The plan anchored at $99-129 against Tilt's $135 and never
    accounted for KegLand's RAPT Pill at ~$48-54, which does more: WiFi and
    Bluetooth, pressure-rated to 5 bar, an optional wireless-charging variant,
    and years of shipping firmware. Asking $99 for an unbuilt product against
    a $50 incumbent is not a pricing question, it is a non-starter. Adds a
    competitive comparison with sources, resets the Phase 0 target, and
    restates both Hub margin references at $55 retail instead of $99.
    The plan now says plainly what the n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
2026-09-14 hardware: add a module-based prototype build for the D1 Mini ESP32
    Everything in hardware/ so far specifies custom SMD boards, which cannot be
    built without a fab run -- so nothing in this repo has ever been assembled,
    and the two questions that block the project (which accelerometer axis runs
    along the housing, and whether the float angle sweeps usefully across the
    gravity range) stayed unanswerable on paper.
    Adds PROTOTYPE_MODULES.md: the same four sensing functions built from
    off-the-shelf breakout modules and jumper wires on a D1 Mini ESP32, with a
    per-module parts list and wiring table.
    Checked against that board specifically rather than assumed: all five pins
    the firmware uses (GPIO4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
2026-09-14 hardware: narrow the bench prototype to Temp + Gravity on the D1 Mini ESP32
    Renames PROTOTYPE_MODULES.md to PROTOTYPE_TEMP_GRAVITY.md and drops the
    standalone temperature, humidity and CO2 module sections -- a file covering
    one build should not be named for four. Those modules are still described in
    MULTI_SENSOR_MODULES.md, which the new file points at, so nothing is lost.
    The space freed goes into the two procedures that actually matter, which the
    broader version only gestured at:
    - The axis test, as concrete steps. It needs no housing, no ballast and no
    sugar: flash, hold the board upright and confirm ~0 degrees, lay it flat
    and confirm ~90. Five minutes retires the assumption the fi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
2026-09-14 firmware/hardware: on-board MCP9808 for temperature, DS18B20 as fallback
    The float is sealed and submerged, so the temperature sensor never needed to
    be a cabled probe -- and once it is a component on the board, a 1-Wire part
    is the wrong choice. An MCP9808 on the accelerometer's existing I2C bus is
    +-0.25 C against the DS18B20's +-0.5 C, costs less, needs no extra GPIO and
    no 4.7k pull-up, and has no counterfeit problem (fake DS18B20s are widespread
    and invisible until readings go strange). For reference KegLand's RAPT Pill
    claims +-0.2 C, which the DS18B20 could not meet.
    The sketch supports both and picks at boot rather than using a compile-time
    switch someone would forget to flip: it pr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
    [fermentation_tilt_v1.ino]
2026-09-14 hardware: cover the ESP32 DevKit V1 in the bench guide, not just the D1 Mini
    Both boards break out all five pins the firmware uses, with identical
    silkscreen labels (IO4, SDA, SCL, IO25, IO34), so the wiring table and the
    sketch are unchanged between them. They differ in one way that matters.
    The DevKit V1 carries an AMS1117, whose ~1.1V dropout means it needs >4.4V in
    to hold 3.3V out. A single Li-ion cell is 4.2V at full charge and falling, so
    powering the board from one through VIN browns out during WiFi transmit --
    and presents as random resets rather than as a power fault, which is exactly
    the kind of thing that costs an evening. Documents the two fixes (regulate the
    cell to 3.3V with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
2026-09-14 hardware: spell out the DevKit V1 power chain with the TP4056
    The TP4056 is easy to mistake for the answer to the DevKit V1's power
    problem, and it isn't: OUT+ is the cell voltage passed through the protection
    MOSFETs, 3.0-4.2V, so feeding it to VIN still sits under the AMS1117's ~1.1V
    dropout and browns out during WiFi transmit. The LDO is the part that makes
    it work, so the guide now draws the whole chain rather than describing it in
    prose -- including the divider tapping the cell side so it measures battery
    voltage rather than the regulated rail, and the LDO's input/output caps,
    without which a bare regulator can oscillate.
    Also gives a way to tell a protected TP4056 module from an unpro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
2026-09-14 hardware: prefer the D1 Mini for the float, and key wiring to GPIO not labels
    The wiring table gave a single silkscreen label per pin, but those were
    verified on the DevKit V1 only -- D1 Mini revisions and clones label the same
    pins differently. Keys the table to GPIO numbers, which is what the firmware
    actually addresses, and lists the common label variants rather than asserting
    one.
    Also makes the D1 Mini the recommended board for the float, since its
    regulator runs directly from a cell: the whole power chain becomes
    cell -> TP4056 -> OUT+ -> 5V pin, with no extra LDO, no capacitors to get
    wrong, and nothing that can oscillate. The DevKit V1 is better used as a
    second rig for the Hub, whe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
2026-09-14 hardware: add a module-level wiring schematic for the bench rig
    Every schematic in this repo so far shows the custom SMD board -- bare
    ESP32-WROOM-32E, TP4056 IC, DW01A/FS8205 -- which is not what anyone
    breadboards. schematic-prototype-d1.html draws what is actually being wired:
    a D1 Mini ESP32, a GY-291 ADXL345 breakout, a TP4056 module, an INR18650 and
    a DS18B20 probe, with every line a wire you physically run and a connections
    table beside it.
    Draws the two details that otherwise cost a bench evening: SDO tied to GND,
    which is what puts the ADXL345 at the 0x53 the firmware expects rather than
    0x1D, and the 4.7k pull-up crossing the ADXL's ground drop without a junction
    dot -- a crossing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
2026-09-14 Clear out stale claims: landing page price and README status
    An audit for superseded values across the repo turned up little genuine
    cruft -- 77 tracked files, no orphaned documents, no broken internal links,
    and every remaining mention of the old R9, the 350mAh cell and the 25-32mm
    housing is in explicit historical context. Two real things were stale, and
    one of them was public.
    LANDING PAGE. The deployed page still advertised "$99-129" and described a
    temperature-only product. Both were wrong: the plan's own competitive section
    now says that price does not survive RAPT at ~$50, and the floating
    temperature-and-gravity unit has been the main development effort since the
    page was written. A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
2026-09-14 Track the rendered PDFs in the repo
    Follows 1157ff7, which removed pdf/ from .gitignore -- the PDFs are wanted in
    the repo, not just handed over once. Regenerated against the current sources
    first so they match HEAD, and drops the now-dangling .gitignore comment that
    had no rule left under it.
    Four documents, ~480 KB total: the module-level wiring schematic for the
    bench rig, the implementation plan, the bench prototype guide and the
    Temp + Gravity parts list. They render from the committed HTML and markdown,
    so they are reproducible rather than authoritative -- if a source and its PDF
    ever disagree, the source wins.
    Claude-Session: htt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
2026-09-14 hardware: warn that "D1 Mini" ships as both ESP8266 and ESP32
    The bench guide named the D1 Mini ESP32 as the preferred board without ever
    saying that the same form factor, under the same name, is far more commonly
    sold with an ESP8266 on it. The two look nearly alike, and picking the wrong
    one is a dead end rather than a setback: fermentation_tilt_v1.ino uses
    <WiFi.h>, <HTTPUpdate.h>, RTC_DATA_ATTR, esp_sleep_enable_timer_wakeup() and
    a 12-bit 3.3V ADC, none of which exist on an ESP8266, so it does not compile
    -- and the 100k/100k divider would over-range that board's 1.0V ADC input
    even after a port.
    Adds the warning to both the guide and the wiring schematic, with how to tell
    the boards a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
2026-09-14 Rebuild the bench docs and PDFs around the ESP32 DevKit V1
    The board that was going to be the ESP32 D1 Mini turned out to be an ESP8266
    D1 Mini, so the DevKit V1 is the only ESP32 in the kit -- and the wiring
    schematic was drawn for the wrong one in a way that mattered. It routed
    TP4056 OUT+ straight to the 5V pin, which is right for a D1 Mini ESP32 and
    wrong for a DevKit V1: the AMS1117's ~1.1V dropout needs >4.4V in to hold
    3.3V out, so a 4.2V-and-falling cell browns out during WiFi transmit, and it
    presents as random resets rather than as a power fault.
    Redraws the power path with the HT7333 in it: cell -> TP4056 -> LDO -> the
    board's 3V3 pin and the sensor rail, with VIN unused. The 3V3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
2026-09-14 hardware: record the float's internal stack budget
    Nothing in the repo said how much room is actually inside the housing, so
    "put the modules on a carrier" looked like an open option. The arithmetic
    says it isn't: a 37mm housing with a 2mm wall is 33mm internally, an 18650
    eats 18.6mm of that, and the 14.4mm left over is less than the ~14.7mm a
    socketed DevKit V1 costs in headers, carrier, board and module -- before any
    ballast, potting or sensor.
    Records the budget and the usable board width by height, and notes that width
    is not the binding constraint: stack height is. This is the concrete reason
    the float needs the bare-module SMD design rather than a dev board on a
    carrier, and it shoul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
2026-09-15 dashboard: add the SPA rewrite so deep routes stop 404ing
    Every route except / returned 404 on the deployed site: /login, /devices and
    /devices/:id all failed. React Router resolves those in the browser, but no
    file of that name exists in dist/, so a direct visit or a page refresh asked
    Vercel for a path it could not serve. Only the root worked, which is what made
    the app look deployed while every deep link was broken -- including the one a
    user hits first, since an unauthenticated visitor is redirected to /login.
    vercel.json now rewrites unmatched paths to /index.html. Vercel checks the
    filesystem before applying rewrites, so /assets/index-*.js and the CSS are
    still served as real files an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
2026-09-15 firmware: WiFi setup portal, so a customer never touches the sketch
    WIFI_SSID and WIFI_PASSWORD were compile-time, which meant shipping this
    product required every customer to install the Arduino IDE and edit source.
    That is not a rough edge, it is a blocker on selling anything.
    Credentials now live in NVS and are entered once from a phone. With none
    stored the device brings up its own open AP, FermentationMonitor-XXXXXX (last
    three MAC bytes, so units in one room stay distinguishable), answers every DNS
    query with its own address so the captive-portal sheet actually pops, serves a
    scan list and a password field, saves and restarts onto the customer's network.
    Three triggers, chosen for a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
2026-09-15 Device identity and claiming: factory provisions, customer claims
    The device row was created by the customer, who then pasted the generated
    secret into the firmware. For anything shipped that is backwards twice over: a
    customer cannot edit a sketch, and the secret must never pass through their
    hands at all.
    Now the factory calls provision_device() with the service_role key, which
    mints a unique id, a 64-char secret and a single-use claim code and inserts
    the row unowned. The unit is flashed with id + secret; the claim code is
    printed on it. The customer types that code into the dashboard, claim_device()
    attaches the row to their account, stamps claimed_at and clears the code so it
    cannot be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
2026-09-15 Rate-limit device claiming, and fix the trap that would have made it a no-op
    claim_device now allows 10 failed attempts per user per hour, logged in a new
    claim_attempts table. At that rate ~39 bits of code space puts a 50% chance of
    hitting any live code years away, even across a thousand throwaway accounts.
    The part worth recording: the obvious implementation does nothing. Signalling
    a bad code by raising aborts the transaction, which rolls back the attempt row
    written moments earlier -- so the counter never accumulates and the limit is
    decorative. The function therefore RETURNS failures instead, which is why its
    return type changes from text to jsonb carrying {ok, error, message,
    retry_a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
2026-09-15 tools: factory provisioning script
    Provisioning a batch by hand means running provision_device() once per unit in
    the SQL editor and copying three values out each time -- error-prone at 20
    units, and it produces nothing you can actually stick on a device. The script
    calls the RPC per unit and writes the three artifacts a build session needs:
    manifest.csv as the master record, a per-unit firmware snippet holding just
    the two CONFIG lines to paste before flashing, and labels.html, a printable
    3-up A4 sheet of claim codes with cut lines.
    Zero dependencies, Node 18+.
    The split matters: labels carry claim codes only and are safe to print and
    hand around, while manifest.csv and the firmware snip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
2026-09-15 firmware: a broken sensor must not make the device invisible
    A failed temperature read ended the wake cycle before connectWiFi(), on the
    reasoning that there was no reading worth posting. That is true of the
    reading and wrong about everything else: it made a unit with a disconnected
    sensor indistinguishable from one that was flat, never flashed, or out of
    WiFi range. All four are simply silent, and for a sealed float whose only
    other diagnostic channel is a serial cable, that is the worst failure mode
    available.
    The device now stays awake, connects, and posts a 'sensor_fault' alert. It is
    latched in RTC memory so a permanently broken sensor doesn't alert every 15
    minutes, re-announced once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
    [fermentation_tilt_v1.ino]
2026-09-16 dashboard: a colored connection indicator, not just a timestamp
    The devices list already printed "Last seen 2026-09-15 16:33" next to every
    row, but reading and comparing a timestamp against the current time is work a
    glance shouldn't require -- especially for the one thing this dashboard exists
    to catch: a unit that's gone quiet.
    Adds a status dot + label, computed from last_seen_at against the device's own
    sleep_interval_seconds (not a fixed number -- a unit someone slowed to save
    battery shouldn't flip to "offline" on the same clock as one posting every 5
    minutes):
    online green, pulsing last check-in <= 1.5x its wake interval
    stale amber <= 4x -- plausibly fine (Wi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
2026-09-17 dashboard: consolidate device settings into one admin panel
    Thresholds and gravity calibration were already editable, but as two
    standalone sections buried at the bottom of the page with no relation to
    each other, and there was no way to rename a device or remove one at all --
    the "001" test device from an earlier session had to be deleted by hand
    with a SQL query, which a real customer has no access to.
    Adds DeviceInfoForm (rename + remove) and wraps it with the existing
    ThresholdForm and CalibrationForm in a single <details> "Settings" panel,
    open by default so nothing that was visible before is now hidden a click
    away.
    Remove is a real delete (ON DELETE CASCADE takes readings and alerts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
2026-09-17 supabase: battery alerts, snooze, unclaim/transfer, email opt-out
    Backend half of the settings expansion (dashboard half is the next commit).
    Four additions, bundled because they all touch ingest_reading/ingest_alert:
    - battery_min_v: optional per-device low-battery threshold. Checked inside
    ingest_reading() itself rather than in firmware, and deliberately not a
    consecutive-breach counter like temperature -- a single low reading is
    real signal, and RTC-memory breach counting doesn't survive a reset,
    which is exactly what lost the above_max test two sessions ago. Dedup is
    "is there already an unacknowledged battery_low alert", which needs no
    device-side state at all. Null by defa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
2026-09-17 dashboard: battery alerts, snooze, unclaim/transfer, notify opt-out, °F
    Frontend half of the settings expansion -- see the previous commit for the
    backend (migration + edge function), verified there independently.
    New: AlertSettingsForm (snooze buttons + unmute + the email checkbox) and
    an Unclaim/transfer block in DeviceInfoForm, both added into the existing
    Settings panel. ThresholdForm gains an optional battery-voltage field,
    blank by default, with an explicit warning not to set it on USB bench
    power. AlertList knows the battery_low reason.
    Unclaiming needs careful handling on the client: unclaim_device()'s return
    value is the only place the new claim code is ever readable (the row is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
2026-09-17 chore: install Impeccable design skill (project-scoped, no auto-hook)
    Adds /impeccable and its 24 commands (audit, polish, critique, bolder,
    distill, etc.) for design-quality work on the dashboard, from
    https://github.com/pbakaus/impeccable. Copied straight from that repo's
    plugin/ source (the ready-to-use Claude Code package: skills/impeccable/
    plus agents/) rather than going through npx impeccable install, since that
    installer's Option 1 path also downloads a compiled engine binary and
    wires a hook that runs it automatically -- more than this project needs
    right now, and more than I wanted to add without asking first.
    Deliberately NOT installed: the PostToolUse/Stop hook. It auto-download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
2026-09-17 chore: run /impeccable init, write PRODUCT.md and live-mode config
    Durable product record for future Impeccable design work (audit, polish,
    critique, etc.), captured via the init interview rather than invented:
    homebrewer/kombucha-maker audience, pre-launch product stage (not just a
    personal tool -- there's a waitlist and a v2 PCB path underway), and named
    competitors (Tilt Hydrometer, iSpindle, Plaato, BrewPi) for positioning.
    No brand commitments recorded -- "Fermentation Monitor" stays a working
    name until the user settles one.
    Also wired .impeccable/live/config.json for live-mode iteration on the
    dashboard (dashboard/index.html as the inject target; no CSP found, so no
    patch or consent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
2026-09-17 dashboard: redesign as a mission-control instrument panel
    Full visual identity replacement, run through Impeccable's new-work flow
    (not a two-line palette swap): concept-seed dealt 6 catalog challengers
    against 7 audience-grounded candidates I derived (Inkbird-style temp
    controller, analog hydrometer, car dashboard, Nest-style thermostat,
    industrial gauge panel, test-bench oscilloscope, mission-control panel);
    the assigned build was index 7. Full derivation, the challenger weighing,
    and the three raises donated from losing directions are recorded in
    .impeccable/surfaces/dashboard.md's direction contract.
    The old system was flat and static by omission, not by choice: zero
    box-shadow, zero CS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
2026-09-17 dashboard: fold connection status into the gauge, close the palette
    Fixes from the finish-review subagent's audit of the mission-control
    redesign (disposition: fix, two material findings):
    1. FIRST VIEWPORT states the glow carries state "directly on the
    instrument, not as a separate badge." ConnectionBadge was exactly that
    separate badge, duplicating what the gauge's own dim/glow already
    signals, on every tile and the device-detail header. Deleted it.
    Gauge.tsx gains two props instead: `subLabel` (freshness text like
    "3m ago", rendered as a third line inside the instrument's own label
    stack -- no new element) and `stale` (drops the gauge to opacity-75,
    distinct from ful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
2026-09-17 docs: write DESIGN.md from the shipped mission-control panel
    Final step of new-work.md's flow: written from the finished, reviewed
    build (disposition: ship, both material fixes verified resolved), not
    from intent -- the documenter subagent read the real source (Gauge.tsx,
    gaugeState.ts, tailwind.config.js, index.css, both page files) and the
    post-fix screenshots, not the direction contract's aspirational language.
    Records the closed three-hue palette (brew amber / approach orange /
    breach red, plus the warm panel neutral scale -- never pure black), the
    two-font split (system sans for prose, tabular monospace strictly for
    live gauge numerals), four named rules tied to specific decisions made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
2026-09-17 fix(dashboard): correct severe text-contrast failure, add gauge severity to aria-label
    Addressing the critique's #2 and #5 priority findings.
    text-panel-600 (#453829, a border/edge token per its own design.json role
    label) was in use as real body text in 6 places -- alert timestamps, gauge
    freshness labels, and form hints across CalibrationForm/ThresholdForm --
    at 1.57-1.66:1 contrast, nowhere near WCAG's 3:1 floor for any text size.
    Moved all six to panel-400.
    panel-400 itself needed fixing too: it held 4.65:1 against the page
    background (panel-950) but only 4.27:1 against panel-900, the actual card
    surface most of that text sits against -- failing AA at its real usage
    context. Lightened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
2026-09-17 fix(dashboard): stop treating fetch failures as legitimate emptiness
    Addressing the critique's #3 priority finding.
    Devices.tsx and DeviceDetail.tsx both discarded query errors and fell
    through to their empty-state copy regardless of why the data was empty --
    "No devices yet," "No readings yet," "No alerts yet -- good sign" all
    rendered the same whether the account was genuinely empty or a request
    had just failed. This product exists to answer "is my batch okay"
    without the owner checking manually; an owner who opens the dashboard
    mid-outage saw the calm "nothing to worry about" screen, which is the
    product's own founding bug fix -- never go silent -- failing at the one
    layer nobody had des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
2026-09-17 fix(dashboard): collapse Settings by default
    Addressing the critique's #4 priority finding.
    The Settings <details> defaulted open, so device info/rename/delete,
    alert thresholds, alerts/notifications, and (for tilt devices) the
    4-coefficient gravity calibration form all rendered expanded on every
    visit to a device page -- confirmed in the settings screenshots from the
    critique's browser-evidence pass. None of it serves the page's actual
    primary task (check if the batch is okay), and it failed 2 of the 8
    cognitive-load checklist items: one thing at a time, and progressive
    disclosure.
    One-attribute fix: removed `open` from the <details> element. No other
    change -- the four forms and their be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
2026-09-17 feat(dashboard): give the Gravity gauge real hydrometer graduation
    /impeccable delight, addressing the critique's design-specificity verdict
    ("could pass for an aquarium controller or a 3D-printer monitor -- swap
    the labels and nothing else gives it away").
    Every gauge in the system reads the same generic way: a needle against a
    redline, labeled TEMP/GRAVITY/BATTERY. Relabel it PH/ORP and it's an
    aquarium controller; NOZZLE/BED and it's a 3D-printer monitor. Specific
    gravity notation is the one measurement that can't be relabeled into a
    different instrument -- no unrelated product's gauge shows a decimal
    scale in this exact convention.
    Added an optional `endLabels: [string, string]` prop t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
2026-09-17 chore: close the dashboard critique backlog, /impeccable polish pass
    Final step of the critique-fix sequence. All 5 priority issues from the
    2026-09-17T09-02-16Z snapshot are now shipped (layout, contrast+aria-
    label, silent-error handling, Settings default-open, and the gravity-
    gauge specificity addition) across 6 commits.
    This pass's own check (impeccable critique-storage latest) found the
    snapshot's tracked fingerprint no longer matches -- every flagged file
    has changed -- and auto-marked it closed:true, preserving its trend
    history for the next critique run to compare against.
    Polish walkthrough: rendered the full real page composition (not fixes
    in isolation) -- hero gauge, gravity g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
2026-09-17 Move device settings to a dedicated tabbed page
    Splits the inline collapsible Settings section on the device detail
    page into its own route (/devices/:id/settings) with four tabs --
    Profile, Setup, Tools, Data -- grouped by what a visit is actually
    for rather than by underlying table:
    - Profile: name, device ID, type, claimed date
    - Setup: alert thresholds + gravity calibration
    - Tools: snooze + unclaim/transfer
    - Data: notify-email toggle + remove device
    The old monolithic DeviceInfoForm and AlertSettingsForm are split
    into five focused components under components/settings/. Unclaim and
    Remove device keep their distinct amber/red bordered warning-panel
    treatment on the new page, unchanged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
2026-09-17 Fix invisible gauge dial track and tick marks
    The gauge's track and tick marks were reported as hard to read.
    Measured contrast confirmed a real bug, not just a subjective
    preference: the track (panel-700, #332a20) sat at 1.26:1 against the
    panel-900/950 surfaces it renders on, and the ticks (panel-600,
    #453829) at 1.57:1 -- both far below WCAG's 3:1 floor for non-text
    UI components, so the dial face was effectively invisible and the
    needle appeared to float with no scale to read it against.
    Ticks now use panel-400 (#9c8a6e), the system's existing
    verified-accessible secondary color (5.31:1 / 5.62:1). The track
    gets a new gauge-specific value, #7a654c (3.21:1 / 3.40:1), dimmer
    than the tick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
2026-09-17 Add ABV, attenuation, fermentation rate, and process-stage analytics
    Adds real-time fermentation analytics for tilt/gravity devices, built
    on the existing calibration and readings_with_gravity system rather
    than a parallel one:
    - ABV: standard line equation, switching to the Balling-derived
    formula above OG 1.060 where the linear approximation under-reads.
    - Apparent and real attenuation (RA = AA * 0.8114).
    - Fermentation rate: SG drop per 24h, normalized to the actual time
    between the two points compared rather than a naive first-minus-
    latest subtraction.
    - An automated 5-stage process state machine (Lag / Active / Slowing
    / Stabilization & Cleanup / Completed), with in-app guidan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
2026-09-18 /impeccable delight: instrument the sign-in, loading, and empty states
    Delight thesis: the first instrument a visitor sees, before they've
    claimed a single device, should already read as this product's own
    gauge cluster powering on -- not a generic form or spinner standing
    in for one. Concentrated at the three moments that actually carry
    that first impression, per Operate-mode guidance (meaningful moments,
    not scattered whimsy):
    - Sign-in/sign-up page was carrying none of the instrument-panel
    system at all -- default Tailwind `stone` grays, an unset
    background, `brew-800`/`brew-700` text with no dark ground under
    it. It read as an unfinished, unbranded form bolted in front of a
    fini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
2026-09-18 docs: update IMPLEMENTATION_PLAN.md with what's actually shipped
    The dashboard bullet and MVP-scope line 4 were still describing the
    original Phase 1 scope; the dashboard has grown well past that since
    (tabbed settings, snooze/unclaim/email-opt-out, and real-time
    fermentation analytics for the floating module -- ABV, attenuation,
    a normalized rate figure, an automated process-stage indicator).
    Annotated in place, matching this doc's existing pattern of dated
    "what's changed since this was written" notes rather than rewriting
    the original plan.
    Also recorded the first real hardware-in-the-loop debugging session:
    a bench Temp + Gravity unit posted temperature successfully end to
    end but never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
2026-09-18 Add a firmware admin console for publishing OTA releases
    The existing OTA mechanism (checkForOTAUpdate() in both sketches)
    already works end-to-end: a device polls a fixed public manifest.json
    once a day and self-updates if it names a newer version. What didn't
    exist was any way to publish a release other than hand-editing
    Storage objects in the Supabase console, or any admin/staff concept
    at all -- every table and RLS policy in this project is scoped to
    "the user who owns this device."
    Added the smallest admin model that works: a settable admin_users
    table (grant by email via SQL, not a hardcoded UID) plus is_admin(),
    rather than baking in one specific account. New /admin/firmware page
    (ga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
    [fermentation_monitor_v1.ino, fermentation_tilt_v1.ino]
2026-09-18 Fix all findings from the dashboard audit
    - [P1] GaugeTileSkeleton's dial track used panel-700 (#332a20, 1.26:1
    contrast) -- the exact color the real Gauge was already moved away
    from earlier this session for being effectively invisible, reintroduced
    in the loading-state copy of it. Screenshot-verified before and after:
    the skeleton's dial silhouette was unreadable, now reads clearly.
    Changed to Gauge Track (#7a654c), matching the real component.
    - [P2] Touch targets measured 34px (standard button pattern, 49
    instances) and 24px (admin console) against the compiled app --
    both under the 44px guideline. Raised the standard pattern from
    py-1.5 to py-2 (34px -> 38px, verified)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
2026-09-18 Add requirements spec and pipeline state for Temp+Gravity module
    Starts the skidl-skills new-circuit pipeline for the floating temp+gravity
    sensor board, drafting SPEC.md from the existing PROTOTYPE_TEMP_GRAVITY.md
    and BOM_TEMP_GRAVITY.md docs rather than re-deriving already-documented specs.
    Claude-Session: https://claude.ai/code/session_01WRSstz8sk6JWkcYjhTbu5g
2026-09-18 Add I2C timeout to tilt module to prevent bus-hang bricking
    A breadboard I2C bus with weak/missing pull-ups can wedge if a device
    holds SDA low mid-transaction. Wire's blocking calls have no timeout
    by default, so a wedged bus hangs setup() forever and the unit never
    reaches goToSleep() again -- matching the observed "posts once, then
    silent for hours regardless of sleep interval" symptom.
    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
    [fermentation_tilt_v1.ino]
2026-09-18 Add circuit architecture for Temp+Gravity module
    Block diagram, net plan, IC selection, skeleton BOM, and design risks
    for the SKiDL pipeline's architecture stage. IC candidates verified live
    against JLCPCB stock via the pcbparts MCP; catches and corrects a wrong
    LCSC part number in the existing BOM doc (Q2 was mapped to a Schottky
    diode instead of an MMBT3904 NPN transistor) and flags real vs. estimated
    pricing deltas for the part-sourcer stage.
    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
2026-09-18 Add sourced BOM for Temp+Gravity module
    Live JLCPCB verification of every part (ICs, passives, connectors) via
    the pcbparts MCP: stock, real pricing, tier, and EasyEDA footprint
    availability. All parts sourced successfully, no sourcing_failures.md
    needed. MCP9808 stock flagged as the closest to the warning threshold.
    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
2026-09-18 Add datasheet summaries for Temp+Gravity module active parts
    Summaries for all 9 significant ICs/transistors, sourced from pcbparts
    MCP spec data plus well-established pinout references. PDF downloads
    failed (network fetch returned HTML redirects, not real PDFs) for all
    parts, so summaries carry that caveat instead of a fabricated pinout;
    DW01A/FS8205A pin numbering is explicitly flagged unverified pending
    manual datasheet confirmation before SKiDL coding, since a wrong pin
    there would silently disable battery protection.
    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
2026-09-18 Add SKiDL circuit code for Temp+Gravity module, ERC passing
    Modular coding (6 blocks) per the orchestrator's block-count rule.
    Installed the SKiDL toolchain (venv + apt kicad-symbols/kicad-footprints,
    since GitHub access to KiCad/kicad-symbols is out of this session's repo
    scope) to actually run ERC rather than claim a result. ERC: 0 errors, 1
    expected warning (CELL_MINUS/GND net merge, intentional). All 29
    footprint strings validated against the installed KiCad footprint
    library.
    Fixed a real bug found by ERC (C5/C6 decoupling caps left pin 1
    unconnected due to `part += net` instead of `part[pin] += net`), and a
    topology bug in the battery-sense filter cap (C9 was wired in series
    between t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
    [__main__.py, battery_sense.py, charge_protection.py, mcu_core.py, power_input.py, regulation.py, sensor_bus.py]
2026-09-18 Add design review for Temp+Gravity module — 0 HIGH findings
    Three-angle review (ERC, architecture-vs-SPEC sanity, SKiDL code
    quality) per the design-review skill. ERC and footprint validation both
    pass clean. 3 MEDIUM findings are pre-fab human verification items
    already flagged elsewhere (DW01A/FS8205A pin numbers, ADXL345 footprint
    mechanical match, antenna keep-out at layout) — none block continuing.
    2 LOW findings document deliberate deviations from the generic SKiDL
    style guide (ref numbering, net casing) made to stay consistent with the
    already-committed architecture/sourcing docs.
    Claude-Session: https://claude.ai/code/sessi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
2026-09-18 Add rendered schematic SVG for Temp+Gravity module
    generate_schematic() (full KiCad .kicad_sch) needs pin x/y/bbox graphics
    that scratch-built parts (TP4056, DW01A, FS8205A, ADXL345) don't carry,
    so used generate_svg() instead (netlistsvg-based, netlist-accurate box
    diagram) per the project's own outputs/*.svg convention. Required two
    environment fixes to get there:
    - Installed netlistsvg via npm (not present in this container).
    - Patched a real upstream skidl 2.3.0 bug in tools/kicad7/gen_svg.py:
    a text-justify lookup dict didn't handle "top"/"bottom" (only
    left/right/center), crashing on at least one real KiCad symbol's
    label. Patched in the local venv only, not part of this repo.
    A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
    [charge_protection.py, sensor_bus.py]
2026-09-18 Add PDF export of the Temp+Gravity module schematic
    Rendered outputs/temp_gravity_module.svg to PDF via headless Chromium
    (pre-installed in this environment), wrapped in a minimal HTML page with
    a custom @page size matched to the SVG's aspect ratio so the full
    diagram fits on one page without scaling artifacts.
    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
2026-09-19 Add ESP8266 D1 Mini bench-prototype project (SKiDL pipeline + firmware port)
    Self-contained sibling project to the production temp_gravity_module PCB
    pipeline, for the user's on-hand ESP8266 D1 Mini + TP4056 micro-USB
    charger breakout + GY-291 (ADXL345) breakout, confirmed by photo. Full
    SKiDL new-circuit pipeline (SPEC -> architecture -> sourcing ->
    datasheets -> coding -> ERC -> schematic), plus a full firmware port.
    Wiring diagram (circuits/esp8266_tilt_prototype/): 4 modular blocks,
    each module modeled as a scratch-built connector part matching its real
    header pinout. ERC passes clean (0 errors, 0 warnings) after fixing a
    real modeling bug caught during development: the TP4056 breakout'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
    [__main__.py, battery_sense.py, charger.py, d1_mini.py, fermentation_tilt_v1_esp8266.ino, sensor_bus.py]
2026-09-19 Confirm TP4056 breakout is protected, update ESP8266 prototype docs
    User's photo of the board (marking "03962A") shows three ICs -- one
    SOP-8 (TP4056) plus two SOT-23-6 (DW01A + FS8205A) -- matching the
    protected-board signature the docs flagged as needing verification.
    Updates SPEC.md, architecture/{block_diagram,design_risks,module_selection}.md,
    sourcing/sourced_parts.md, and README.md to reflect the confirmation;
    remaining unverified items (D0-RST jumper, A0 onboard divider, GY-291
    SDO pull) are unchanged.
    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
2026-09-19 Wire GY-291 CS explicitly, confirm SLEEP jumper pad from board photos
    GY-291 photo shows CS is its own dedicated header pin (same as SDO),
    not internally tied on this clone -- changed from NC to wired to 3V3
    in sensor_bus.py rather than leaving a CMOS input floating. ERC still
    passes clean (0/0) after the change; schematic/netlist/BOM regenerated.
    D1 Mini back-side photo shows a labeled "SLEEP" solder-jumper pad next
    to D0 -- almost certainly the manufacturer's provided D0-to-RST wake
    connection, appearing unbridged. Updated SPEC.md, architecture/{net_plan,
    design_risks}.md, README.md, and sourcing/sourced_parts.md to point at
    bridging that pad (solder blob or 0R resistor) instead of runnin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
2026-09-19 Confirm D0-RST SLEEP jumper soldered on ESP8266 prototype
    User has bridged the "SLEEP" solder-jumper pad next to D0 -- the last
    of the three hardware items flagged as needing physical verification is
    now done (TP4056 protection and GY-291 SDO/CS were confirmed earlier).
    Only the A0 onboard-divider check remains open. Recommends a quick
    multimeter continuity check on the new D0-RST bridge before the first
    real deep-sleep cycle, since a cold joint there is behaviorally
    identical to "board never wakes."
    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
2026-09-19 Redesign battery divider as two-stage, confirm all hardware items
    User confirmed (multimeter/inspection) this D1 Mini clone has its own
    onboard divider on A0 (~220k/100k, ratio ~0.3125) between the header pin
    and the ESP8266 chip -- unlike a genuine Wemos D1 Mini, which has none.
    This makes the previous single-stage 330k/100k external divider (sized
    to reach 0-1.0V directly) redundant with the board's own attenuation,
    wasting most of the ADC's resolution.
    Redesigned as a two-stage system: external R1/R2 changed to 10k/22k,
    now targeting the board's ~3.2V header-pin ceiling instead of the
    chip's 1.0V limit directly (the onboard divider does that second
    stage). At a 4.2V max cell: header stay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
    [battery_sense.py, fermentation_tilt_v1_esp8266.ino]
2026-09-19 Add Prototype Shield physical build guide (diagram + steps)
    New BUILD_GUIDE.md plus a rendered PDF (outputs/protoshield_build_guide.pdf)
    and standalone diagram SVG, covering physical assembly on the user's
    Arduino-style Prototype Shield v.5 -- distinct from the SKiDL schematic,
    which shows electrical connectivity, not where things actually sit on
    this specific shield.
    Diagram is a custom top-down layout (not a photo trace) marking the
    shield's existing unused features (RESET, S1/LED2, ICSP, SOIC pads,
    Digital I/O and Analog In headers -- none Uno-pitch-compatible with the
    D1 Mini), placement zones for the three modules, wire routing color-coded
    by net type, and off-board callouts for the ba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
2026-09-19 esp8266-tilt-prototype: swap DS18B20 probe for MCP9808 I2C breakout
    The DS18B20 TO-92 probe was too bulky for a PCB-mounted build. Replaced
    it with an MCP9808 I2C breakout sharing the GY-291's existing bus --
    no new GPIO, no new pull-up. Wiring-only change: mcp9808Begin() already
    runs before the DS18B20 fallback path in setup(), so no firmware logic
    changed (only two stale comments that claimed the MCP9808 would never
    be found on this build).
    Also fixes two netlistsvg/elkjs schematic-rendering crashes surfaced by
    this change (unrelated to circuit correctness -- ERC was clean
    throughout): a functionally-typed pin wired only to NC produces a
    malformed netlist export (fixed by declaring d1_min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
    [__main__.py, d1_mini.py, fermentation_tilt_v1_esp8266.ino, sensor_bus.py]
2026-09-19 esp8266 firmware: print tilt reading even when temp sensor is unwired
    Bench-testing convenience for bringing up the ADXL345 before a
    temperature sensor (MCP9808 or DS18B20) is connected. Previously, a
    failed temperature read short-circuited the cycle before the tilt value
    was ever printed, even though the ADXL345 read itself had already
    succeeded -- so there was no way to see tilt data on the serial monitor
    without a temp sensor wired. Posting/WiFi/alert logic is unchanged; only
    adds a debug print in the already-existing early-return path.
    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
    [fermentation_tilt_v1_esp8266.ino]
2026-09-23 docs: full code and UI audit (2026-09-23)
    Findings only, no fixes: 4 P0, 11 P1, 14 P2, 5 P3 across dashboard,
    Supabase, firmware, and landing. Evidence from tsc/build/lint runs, the
    impeccable detector, and headless renders at 1280px and 375px.
    Claude-Session: https://claude.ai/code/session_01Byrgm1wm47NSKFsR1Qjg89
2026-09-23 Fix all findings from the 2026-09-23 code and UI audit
    Blocking:
    - Connection status no longer freezes: useNow() ticks every 30s and on
    focus, Realtime readings update last_seen_at, and the device list
    refreshes in the background.
    - alert-notify fails closed without WEBHOOK_SECRET, compares it in
    constant time, and re-reads the alert from the database.
    - A cleared numeric field can no longer save 0: explicit form parsing,
    CHECK constraints, and range clamping in both firmware sketches.
    - Fermentation analytics load 72h and filter to the current batch, so
    COMPLETED is reachable and a previous batch can't skew the stage.
    Also: phone-safe device list header, contrast fixes (stage bar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
    [fermentation_monitor_v1.ino, fermentation_tilt_v1.ino]
2026-09-23 Sign-in: fix all findings from the /impeccable critique
    Refine-in-place pass on Login and ResetPassword, per the 23/40 critique
    saved in .impeccable/critique/:
    - The password label no longer wraps the Forgot button (it had bound the
    label to the button, leaving the field unlabeled); shared AuthField ties
    label and input with htmlFor/id
    - noValidate plus per-field errors (aria-invalid/describedby, focus the
    first invalid field); no length check on sign-in; color-scheme: dark and
    themed autofill
    - Contrast: panel-500 input borders (3.21:1), solid busy button (5.70:1)
    - Supabase errors mapped to product copy with recovery actions (reset,
    resend confirmation, sign in instead); error b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
2026-09-23 Add DHT11 as an alternative temperature sensor for the Hub
    A compile-time switch (TEMP_SENSOR_DHT11) swaps the DS18B20 for a DHT11
    on the same GPIO4. It waits for the sensor's power-up time and retries a
    failed read once. The README covers the library, the wiring, and the
    DHT11's limits: it reads air only, is accurate to ±2 °C, and covers
    0–50 °C.
    Claude-Session: https://claude.ai/code/session_01NgAWYf9jDqeaqCWUFUCgMb
    [fermentation_monitor_v1.ino]
2026-09-23 Add esp32-devkit-tilt-prototype: same bench rig, ESP32 Dev Kit V1 MCU
    New sibling project to esp8266-tilt-prototype/ -- same three
    user-supplied breakouts (TP4056 charger, GY-291/ADXL345, MCP9808 I2C
    temp sensor) and ungated battery divider philosophy, but targeting a
    generic ESP32 Dev Kit V1 (30-pin WROOM-32 breakout) instead of an
    ESP8266 D1 Mini.
    Unlike the ESP8266 port, firmware needed almost no adaptation: the
    production board's own fermentation_tilt_v1.ino already targets a bare
    ESP32 with the exact same GPIO numbers this design uses (GPIO4/21/22/
    25/34) -- RTC_DATA_ATTR, Preferences/NVS, native 12-bit/0-3.3V ADC, and
    single-argument HTTPClient::begin() all carry over unchanged. The o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
2026-09-23 esp32-devkit-tilt-prototype: swap MCP9808 for DHT11 (user has one on hand)
    Replaces the MCP9808 with a DHT11 as this build's only temperature
    sensor -- unlike the MCP9808<->DS18B20 swap on the sibling rigs (both
    share firmware auto-detect logic), this is a genuinely different sensor
    family and needed real firmware changes, not just rewiring:
    - New Arduino libraries: Adafruit's "DHT sensor library" + its
    "Adafruit Unified Sensor" dependency (installed and compile-verified).
    - All MCP9808 I2C register code and the DS18B20 OneWire/DallasTemperature
    fallback path removed from firmware; replaced with a DHT11 read
    function. Humidity is read and logged to serial but not posted (no
    humidity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
    [__main__.py, dht11.py, fermentation_tilt_v1_esp32_devkit.ino, mcu_core.py, sensor_bus.py]
2026-09-23 Add humidity_pct so the ESP32 Dev Kit V1's DHT11 reading posts
    Adds a nullable humidity_pct column to readings (null for every device
    type except the ESP32 Dev Kit V1 bench rig's DHT11 -- all other sensors
    on this project are temperature-only), via a new migration:
    - readings.humidity_pct (nullable numeric)
    - ingest_reading() gets a new optional p_humidity_pct parameter
    (default null, so every existing caller keeps working unmodified) --
    drop-and-recreate since a new parameter changes the function's type
    signature, same pattern tilt_gravity_support.sql used for p_tilt_deg
    - readings_with_gravity view's explicit column list updated to expose it
    Firmware (fermentation_tilt_v1_esp32_dev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
2026-09-23 esp32-devkit-tilt-prototype: DHT11 pull-up (confirmed bare 4-pin); dashboard humidity gauge
    User photo confirmed the actual DHT11 is Asair's bare 4-pin sensor
    (VDD/DATA/NC/GND, no PCB) -- not the 3-pin breakout with an onboard
    pull-up that dht11.py originally modeled. Adds R3 (10k, same MPN
    already sourced for the ESP8266 rig's original divider) between
    DHT_DATA and DEVKIT_3V3. Re-verified: ERC 0/0, footprints 7/7, schematic
    SVG/PDF regenerated clean on the first attempt -- DEVKIT_3V3's existing
    same-part fan-out (GY-291 VCC+CS, needing the symio="output" render
    fix) is unaffected, since R3 and the DHT11's VDD are each single-
    endpoint sinks on that net.
    Datasheet summary corrected with the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
    [dht11.py]
2026-09-24 esp32-devkit-tilt-prototype: add Prototype Shield v.5 build guide
    Physical mounting guide for the bench rig, mirroring the ESP8266
    sibling's, previously scoped out pending a request:
    - BUILD_GUIDE.md: numbered assembly steps (dry-fit, mount, wire), a
    power-on/first-boot checklist, and reference tables for connections
    and parts.
    - outputs/protoshield_build_diagram.svg: placement diagram with
    color-coded power/ground/signal wiring and numbered callouts matching
    the guide's steps. Generated via a Python script (not hand-typed SVG)
    for precise, iterable layout. The ESP32 Dev Kit V1 is drawn as a
    simplified logical-pin view (only the used GPIOs, labeled) rather
    than a full 30-pin s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
2026-09-24 esp32-devkit-tilt-prototype: confirm GY-291 by photo
    User photo of the GY-291's silkscreen (GND VCC CS INT1 INT2 SDO SDA
    SCL) confirms SDO/CS are dedicated pins, not internally tied, and the
    printed X/Y/Z axis diagram is present -- matches what was already
    documented for the ESP8266 sibling rig, so this removes the "carry
    over only if same physical board" hedge across module_selection.md,
    sourced_parts.md, design_risks.md, README.md, and BUILD_GUIDE.md.
    Regenerated outputs/protoshield_build_guide.pdf to match the updated
    guide text.
    Also fixed a pre-existing formatting gap in module_selection.md's
    TP4056 row (missing Status column).
    Documentation only -- no circuit or firmware changes.
    Co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
2026-09-24 Add claude-flow MCP server to project config
    Claude-Session: https://claude.ai/code/session_0126oJGGbh4tx488SVvkQuDy
2026-09-24 Add claude-flow MCP server to project config
    Registers claude-flow (pinned 3.44.0) as a stdio MCP server in .mcp.json
    and ignores its local runtime state directories.
    Claude-Session: https://claude.ai/code/session_01BVKXTSjcvogR7TntKhuj6U
2026-09-24 Start claude-flow MCP from global install instead of npx
    npx -y downloads ~570 packages on a cold container, exceeding the 30s
    MCP connect timeout. The environment setup script now installs
    claude-flow@3.44.0 globally, so launch that binary directly.
    Claude-Session: https://claude.ai/code/session_01MYC9AsRU3AGHiQfiu3DypU
2026-09-24 Add SessionStart hook for Claude Code on the web
    Installs dashboard npm dependencies and the claude-flow MCP server
    (globally, skipping onnxruntime-node's unreachable CUDA download) so
    lint, typecheck, tests and the MCP server work in web sessions.
    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
2026-09-24 Add atelier skill for anti-AI-slop UI design
    Design-director workflow: ground choices in the subject, plan tokens
    before code, attack the plan against first- and second-order AI
    defaults, push one frontier CSS move, then gate on a scanner and a
    six-axis critique. Synthesised from Anthropic's frontend-design,
    Hallmark, avoid-ai-design and Impeccable; vendors avoid-ai-design's
    MIT-licensed detect.mjs scanner.
    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
2026-09-24 Apply atelier audit to dashboard and landing page
    Dashboard:
    - Calibrated floats read gravity on the large dial; temperature moves to
    the small dial and keeps its alert glow
    - Device tiles show a float's gravity and name any open alert, so a dead
    sensor no longer looks like a switched-off device
    - One gravity + temperature chart with limits replaces three overlapping
    charts; rate chart gets whole-point ticks
    - One absolute time format across alerts, charts, settings and admin
    - Sentence case everywhere except gauge labels and claim codes
    - 44px inputs in every form; gauge end labels moved inside the ring
    Landing page:
    - Moves onto the dashboard's palette and type
    - Left-aligned hero w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
2026-09-24 esp32-devkit-tilt-prototype: move I2C SDA from GPIO21 to GPIO23
    The bench board's GPIO21 pad is damaged, and the ADXL345 stopped
    responding (every reading since 12:29 UTC on 2026-09-24 has a null
    tilt_deg). The ESP32 routes I2C through its GPIO matrix, so SDA can use
    any free bidirectional pin. GPIO23 sits next to GPIO22 (SCL) on the Dev
    Kit V1 header and is neither a strapping nor a flash pin.
    Updates the bench sketch's I2C_SDA, the SKiDL pin, the build guide, spec,
    net plan, block diagram, datasheet summaries and the protoshield diagram
    label. The production board keeps GPIO21.
    Claude-Session: https://claude.ai/code/session_01MYC9As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
    [fermentation_tilt_v1_esp32_devkit.ino, mcu_core.py]
2026-09-24 Add project SKiDL MCP server
    tools/skidl_mcp.py exposes the repo's SKiDL designs over MCP: list
    circuits and their block files, build a design (ERC, netlist, BOM),
    search KiCad symbol libraries and show a part's pins. Registered as
    'skidl' in .mcp.json; runs via uv with inline script dependencies.
    Claude-Session: https://claude.ai/code/session_01DqD9HQo1V1cXgAgRuvhfdr
2026-09-24 Add tracer-gas leak sniffer: circuit, firmware, survey schema, web app
    A handheld hydrogen sniffer for locating buried/in-slab water leaks with
    forming gas (5% H2 / 95% N2), streaming to a new /sniffer dashboard page.
    - leak-sniffer/circuits: SKiDL design (ESP32-S3-WROOM-1, TGS2616-C01 H2
    sensor read ratiometrically by an ADS1115, SHT40, MT3608 5V boost for
    heater + sample pump, MCP73831 charger, soft power switch). ERC clean.
    - leak-sniffer/firmware: BLE streaming (20-byte packets that fit the
    default MTU), warm-up detection, zero/mark button, Geiger-style buzzer,
    idle power-down. Compiles clean on arduino-esp32 3.3.12.
    - supabase: leak_surveys + leak_survey_points with owner-only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
    [__main__.py, mcu_core.py]
2026-09-24 Remove leak sniffer (moved to novaclaw38/hydrogen_leak_sniffer)
    Reverts 557c45c. The tracer-gas leak sniffer now lives in its own repo,
    https://github.com/novaclaw38/hydrogen_leak_sniffer, so this branch goes
    back to just the SKiDL MCP server change.
    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
    [__main__.py, mcu_core.py]
2026-09-25 esp32-devkit-tilt-prototype: add I2C diagnostic sketch for the GY-291
    Checks idle SDA/SCL levels, scans the bus on the expected, swapped and
    original pin pairs, and reads the ADXL345 ID and one sample at 0x53 or
    0x1D, so a null-tilt rig shows which wire or address is wrong.
    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
    [i2c_diagnostic.ino]
2026-09-25 esp32-devkit-tilt-prototype: note loose-jumper cause of null tilt
    The 2026-09-24 tilt dropout was a breadboard jumper that had worked
    loose. Adds a troubleshooting note under the axis-test step pointing at
    the I2C diagnostic sketch and recommending soldered or fresh GY-291 wires
    before a long run.
    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
2026-09-29 Dashboard: clean chart ticks, alert age on tiles, time in range
    - Chart time axes tick on local 6-hour boundaries ('Mon 6 PM') instead of
    evenly spaced from the first reading (07:14 AM)
    - Device tiles show how old an open alert is, and note when a temperature
    alert's reading has returned inside its limits; status lines balance
    their wrapping and never split '40m / ago'
    - Detail hero panel gains a time-in-range summary computed from the
    readings on file, with missing time reported rather than counted
    - describeOpenAlert, timeTicks and computeTimeInRange are unit tested
    DESIGN.md records the second audit pass.
    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
2026-09-29 Dashboard: gauges wake when a device reports or returns
    When a gauge already on screen goes from offline to live (a device's first
    reading, or its return after going silent), the needle sweeps in from zero,
    the glow and hub warm up, and the numeral lands as the needle arrives.
    Never on first paint, and skipped under prefers-reduced-motion.
    Needle and hub colour and glow now transition, so state changes settle
    instead of snapping; the acknowledged alert dot fades. A device that has
    never reported says it is waiting for its first reading.
    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
2026-09-30 Dashboard polish: silent-device state, even chart axes, labelled inputs
    - A device that has reported before but has nothing in the 48-hour window
    now says so and names the fix, instead of every chart saying 'No readings
    yet' next to dead dials
    - Chart value axes use evenly spaced round ticks (niceTicks) instead of
    Recharts' padded-domain ticks such as 1.065 / 1.040 / 1.025 / 1.010
    - Admin firmware file inputs get labels (axe critical)
    - Start new batch, Unclaim device, Remove device, Publish, file inputs and
    device-type radio rows reach 44px
    - Low-battery field stacks like its siblings; calibration placeholders are
    example values rather than a truncated copy of the hint
    axe-core r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
2026-10-01 esp32-devkit-tilt-prototype: move I2C SCL from GPIO22 to GPIO19
    The bench board's GPIO22 pad is faulty (GPIO21 already was; SDA moved to
    GPIO23). The ESP32 routes I2C through its GPIO matrix, so SCL can use any
    free bidirectional pin. GPIO19 is free, neither a strapping, flash nor
    input-only pin, and shares a header side with GPIO23.
    Updates the bench sketch's I2C_SCL, the SKiDL pin, the build guide, spec,
    net plan, block diagram, risk notes, datasheet summaries and the protoshield
    diagram label. The I2C diagnostic now tries 23/19 first and also the
    previous 23/22 and original 21/22 wirings. The production board is
    unchanged.
    Claude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
2026-10-02 Add Arduino IDE setup and flashing guide for the bench rig
    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
2026-10-02 Move bench rig I2C to SDA GPIO26 / SCL GPIO27
    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
